quentinper/Orphea/020925_AA-Orphea_equipe/030925_AA_Orphéa/030925_--_Document_Conception/030925_40_--_PCB_Orphéa_Commande_Solénoide.pdf

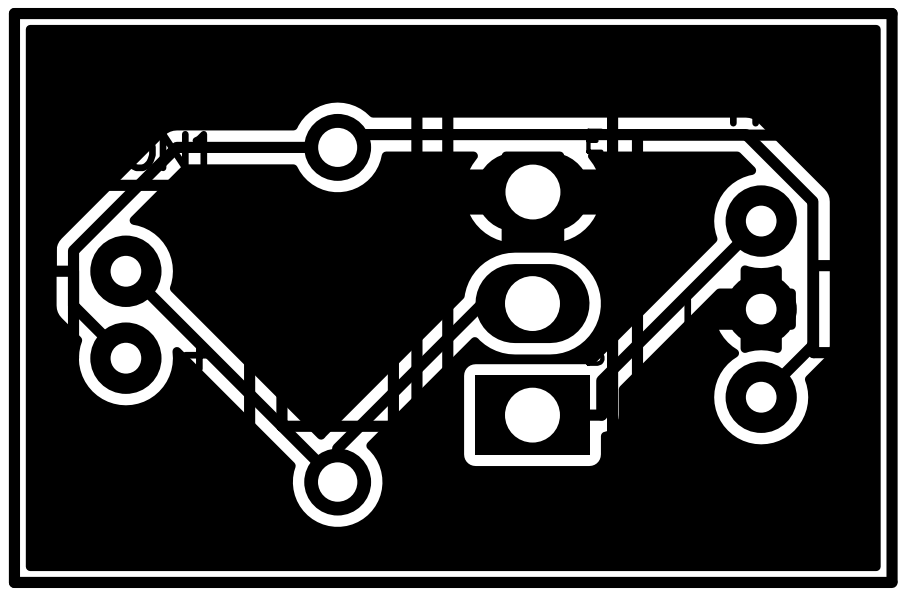
[picture p18: page 1]
