quentinper/Orphea/020925_AA-Orphea_equipe/030925_AA_Orphéa/030925_--_Document_Avant_Projet/030925_03_--_Analyse_fonctionnelle.pdf

BUT 3 – SAE S5

CY IUT – GEII Neuville

# Analyse fonctionnelle

### Projet Clavier Automatisé

Document rédigé par : William Le Coënt & Lorenzo Salvatore & Quentin Perbost
Ref : 05092025_3_–

BUT 3 – SAE S5 | Analyse Fonctionnelle
Projet Clavier Automatisé

ENREGISTREMENT DES MODIFICATIONS

Version | Date | Auteur | Modification
– | 05/09/2025 | W.LE-COËNT | Création / Réalisation
AA | 07/10/2025 | Q.PERBOST | Finition

### APPROBATION

| Nom | Rôle | Signature | Date
Écrit par | W.LE-COËNT | Technicien
Vérifié par | L.SALVATORE | Technicien
Approuvé par | Q.PERBOST | Technicien
Approuvé par le client si nécessaire | V.GAUTHIER | Client
Ref : 05092025_3_– | 2

### Contexte

Ce document à pour objectif de décrire les besoins du client liés au projet Orchestrion du clavier automatisé.

Ce document est applicable pour le projet “ Clavier Automatisé ”

### Table des matières

### 1 - Etude Pré Projet

1.1 - Diagramme Bête à corne

Il permet d’identifier le besoin fondamental, l’utilisateur et l’objectif principal du système.

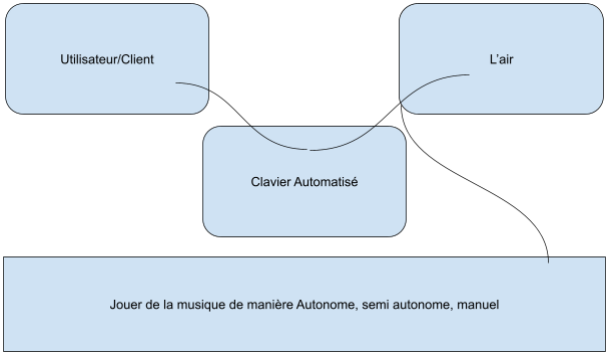
[picture p22: figure]

1.2 - Diagramme Pieuvre

Il met en évidence les interactions entre le système étudié et son environnement (acteurs ou contraintes externes).

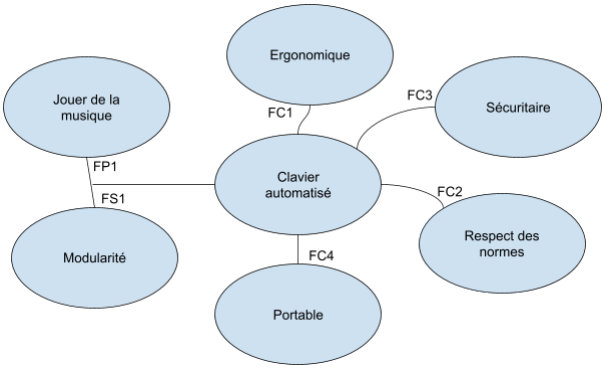
[picture p23: figure]

1.3 - Diagramme FAST

Il décompose les fonctions d’un système en les reliant sous forme logique pour comprendre comment elles répondent au besoin.

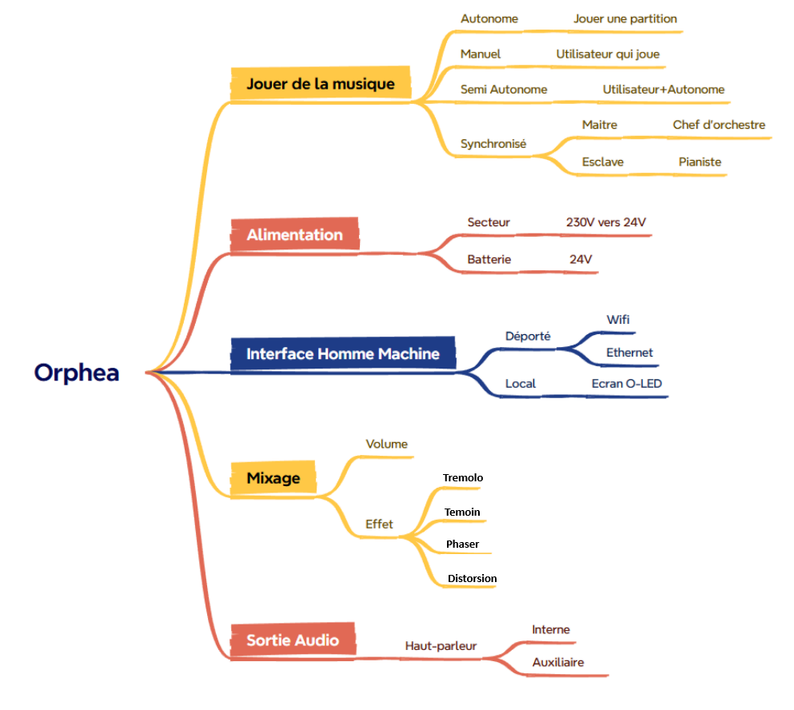
[picture p24: figure]

1.4 - Chaîne d'énergie et de communication

Elle décrit comment l’énergie et les informations circulent dans le système, depuis l’entrée jusqu’à la sortie.

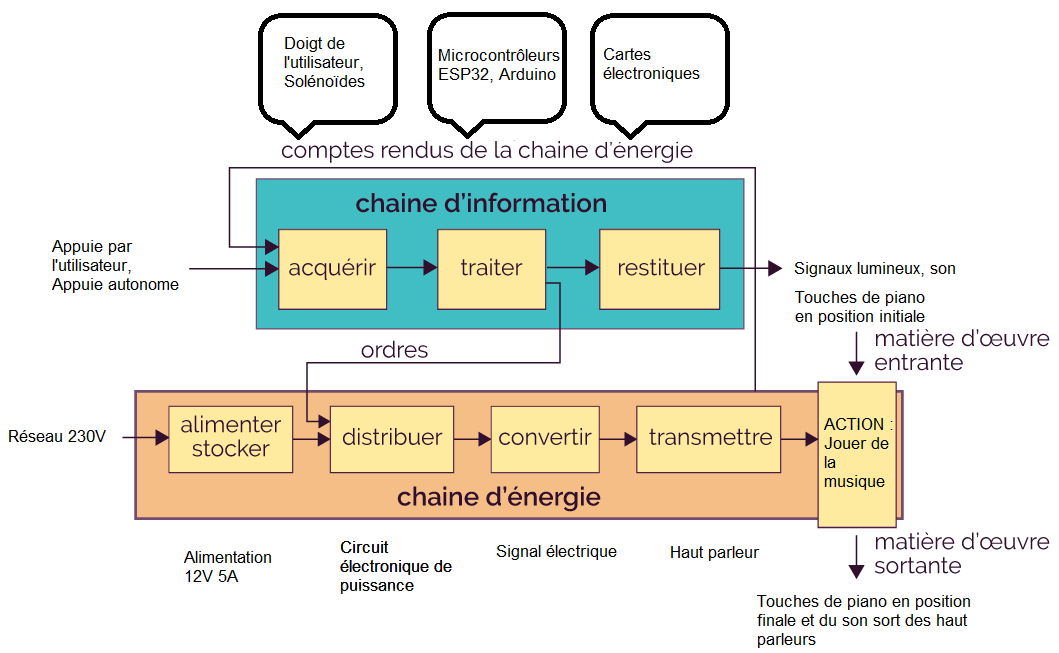
[picture p25: figure]
