quentinper/Orphea/020925_AA-Orphea_equipe/080925_AA_Programmation/080925_--_Environnement_de_Compilation/080925_140_--_Notice_de_Compilation.pdf

BUT 3 – SAE S5

CY IUT – GEII Neuville

# Notice de Compilation

## Projet Orphéa

### Document rédigé par : William Le Coënt & Lorenzo Salvatore & Quentin Perbost Réf : 08092025_140_– _Notice_de_Compilation

BUT 3 – SAE S5 | Notice de Compilation
Projet Clavier Automatisé

### ENREGISTREMENT DES MODIFICATIONS

Version | Date | Auteur | Modification
– | 05/01/2026 | Q.PERBOST | Création

## APPROBATION

| Nom | Rôle | Signature | Date
Écrit par | Q.PERBOST | Technicien
Vérifié par | L.SALVATORE | Technicien
Approuvé par | W.LE-COËNT | Technicien
Approuvé par le client si nécessaire | V.GAUTHIER | Client
Ref : 080925_140_– | 2

## Contexte

Ce document à pour objectif de décrire la mise en place de l’environnement de compilation et de programmation du projet.

Ce document est applicable pour le projet Orphéa

## Table des matières

## 1. Prérequis

- Votre Machine doit être équipé de Visual Studio Code.

### - Les pilotes de la carte ESP32 doivent être installés ils sont en lien ci dessous :

★ Lien-driver (https://randomnerdtutorials.com/install-esp32-esp8266-usb-drivers-cp210x-windows/)

## 2. Document de référence

### Ce munir de la dernière version à jour du software

– | SAE-S5V3 (https://drive.google.com/drive/folders/1pqauAC_4ReTE95huv6Qkbq_bhtFuraPZ?usp=drive_link)

## 3. Installation de PlatFormIO

Cette partie ne concerne que les personnes n’ayant pas déjà installer le plugin.

L’installation du plugin PlatForm se verra sous la forme d’une procédure,

Veuillez compléter celle- ci pour ne pas oublier d'étape.

Etape | Description | Résultat
1 | Ouvrir VS Code
2 | Cliquez sur l'icône suivante :

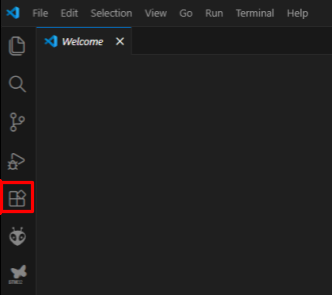
[picture p26: figure]
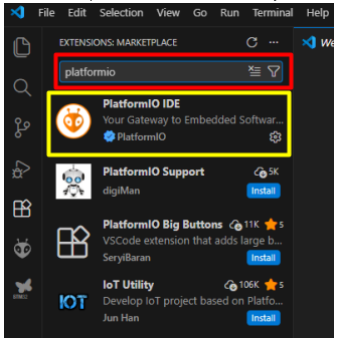
[picture p27: figure]

3 | Saisir “platformio” et cliquez sur l’extension entouré en jaune

4 | Cliquez sur Install et attendez la fin de l’installation

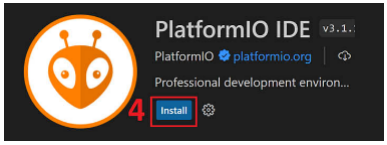
[picture p28: figure]

5 | Redémarrez VS Code, vous devriez avoir le logo PlatformIO : Cliquez dessus

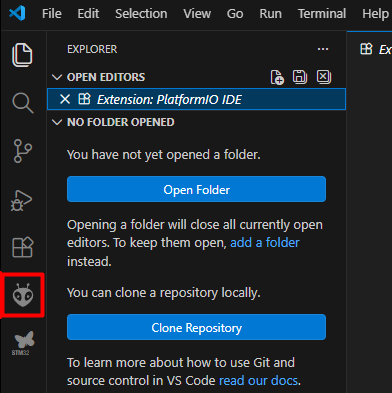
[picture p29: figure]

6 | Selectionnez : Pick a folder

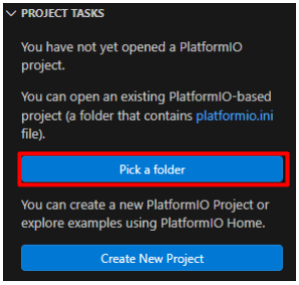
[picture p30: figure]
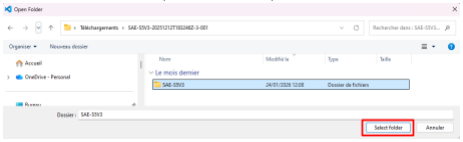
[picture p31: figure]

7 | Ouvrez le fichier SAE-S5V3 ( Dernier Software)

8 Pour compiler le projet, ou l’upload sur l'esp 32 :

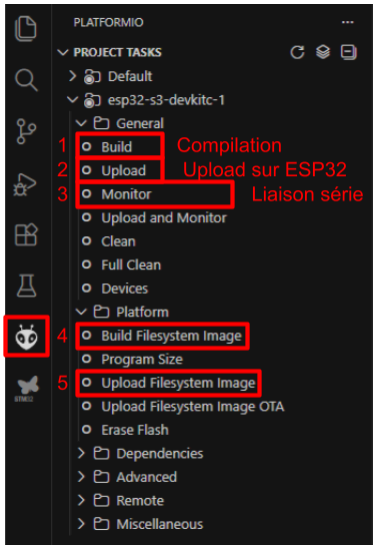
[picture p32: figure]

Pour une compilation après changement sur une partie C/C++ ayant eu lieu dans le répertoire : → lib ou → src
Etape à suivre 1→2→3

Si une modification concerne un programme dans le répertoire : → Data Etape à suivre 4→5→2→3

## Nota

Une erreur de port de communication peut avoir lieu lorsque plusieurs carte sont connectés au même PC, pour éviter cette erreur vous pouvez sélectionner le port voulus

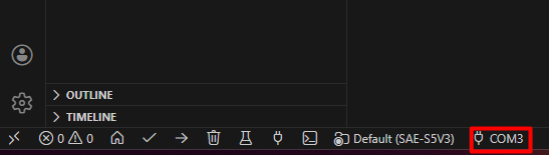
[picture p33: figure]

Cliquez ensuite sur le port de la carte à programmer.
