quentinper/Orphea/020925_AA-Orphea_equipe/030925_AA_Orphéa/030925_--_Document_Fabrication/030925_01_--_BOM_Orphéa.pdf

# LISTE DES ARTICLES NON CODIFIES

## NOT CODIFIED ITEMS LIST

QTE QTY | UNITE Unit | DESIGNATION NAME | CODE FABRICANT MANUFACTURER CODE | FABRICANT MANUFACTURER | EQUIVALENT ACCEPTE ACCEPTED ALTERNATIVE | REPERE TOPO TOPO ARK | OBSERVATION COMMENT
26 | | JST 2 Pin | B2B-PH-K-E(LF)(SN) CONN-TH_B2B-PH-K-S | | NON | IN 1/2/3/4/5 /6/7/8/9/10/11/12/ 13/14/15/16/17/18/ 19/20/21/22/23/24/25/26
26 | | JST 3 Pin | JST-3-PTH-VERT | | NON | SOL 1/2/3/4/5/6/7/8 9/10/11/12/13/14 15/16/17/18/19/20 21/22/23/24/25 SW1
3 | | Réseau de résistance 8*1 | RESEAU_DE_8_RESISTANCES | | OUI | RN1 RN2 RN3
1 | | Conencteur Dupon Male 1*4 | HDR-F-2.54_1x4 | | OUI | H5
1 | | Conencteur Dupon Male 1*16 | HDR-F-2.54_1X16 | | OUI | H6
1 | | Conencteur Dupon Male 1*6 | HDR-F-2.54_1X6 | | OUI | H7
1 | | Conencteur Dupon Male 1*8 | HDR-F-2.54_1X8 | | OUI | H8
4 | | Conencteur Dupon Male 1*10 | HDR-F-2.54_1X8 | | OUI | H1 H2 H3 H4
1 | | ESP 32 N16R8 | ESP32 S3 N16R8 | | NON | U1
1 | | ARDUINO Mega | Mega 2650 Pro mini 5V | | NON | U11
1 | | DAC I2S UDA1334A | UDA1334A Module Custom | | NON | U3
1 | | Régulateur L7812CV | L7812CV | | OUI | U8
1 | | Régulateur L7809CV | L7809CV | | OUI | U9
1 | | Régulateur L7805CV | L7805CV | | OUI | U10
1 | | Régulateur LM1086T 3,3V | LM1086T 3,3V | | OUI | U7
1 | | Barrel Jack DC 9-24V | 9-24V/50W 5.5X2.1 BARREL JACK | | OUI | U2
4 | | Condensateur 330 nF | C_RAD-0.2_US | | OUI | C4 C7 C9 C13
3 | | Condensateur 100 nF | C_RAD-0.2_US | | OUI | C5 C6 C8
2 | | Condensateur 10 µF | C_Tan_SMD_A_EU | | OUI | C10 C11
1 | | Condensateur 330 µF | C_Tan_SMD_A_EU | | OUI | C12
1 | | Condensateur 10 nF | C_RAD-0.2_US | | OUI | C14
1 | | Condensateur 1 µF | CE_TH_D5.0×F2.0_EU | | OUI | C15
1 | | Condensateur 47 nF | C_RAD-0.2_US | | OUI | C16
1 | | Condensateur 250 µF | CE_TH_D5.0×F2.0_EU | | OUI | C17
2 | | Diode 1N4148 | 1N4148 | | OUI | D1 D2
5 | | Résistance 1/4W de 10k Ohm | R_AXIAL-0.4_EU | | OUI | R2 R4 R5 R25 R26
1 | | Résistance 1/4W de 27k Ohm | R_AXIAL-0.4_EU | | OUI | R1
1 | | Résistance 1/4W de 18k Ohm | R_AXIAL-0.4_EU | | OUI | R3
1 | | Résistance 1/4W de 5,1k Ohm | R_AXIAL-0.4_EU | | OUI | R6
1 | | Fils | NA | | OUI | R7 R8
1 | | Résistance 3 W 1k Ohm | R_AXIAL-0.6_EU | | OUI | R10
1 | | Amplificateur Audio | LM386N-1_C2835213 | | NON | U12
DESSINE / DRAWN : | REV | DATE | MODIFICATION
| -- | 11/12/2025 | Creation
VISA : | 1/1 PLANCHE / SHEET : | | DESIGNATION / NAME :

VERIFIE / CHECKED :
030925_01_--_BOM_Orphéa | --

APPROUVE / APPROVED :
