quentinper/Orphea/020925_AA-Orphea_equipe/030925_AA_Orphéa/030925_--_Document_Fabrication/030925_01_--_BOM_Orphéa_Commande_Solénoide.pdf

# LISTE DES ARTICLES NON CODIFIES

## NOT CODIFIED ITEMS LIST

QTE | UNITE | DESIGNATION | CODE | FABRICANT | EQUIVALENT | REPERE | OBSERVATION
1 | | JST 2 Pin | B2B-PH-K-E(LF)(SN) CONN-TH_B2B-PH-K-S | | NON | CON1
1 | | JST 3 Pin | 2 pin connector | | NON | H1
1 | | Diode 1N4007 | 1N4007W | | OUI | D1
1 | | D44H11 | D44H11_C3200935 | | OUI | Q1
DESSINE / DRAWN : | REV | DATE | MODIFICATION
| -- | 11/12/2025 | Creation
VISA : | PLANCHE / SHEET : 1/1

VERIFIE / CHECKED :

APPROUVE / APPROVED :

030925_01_--_BOM_Orphéa_Commande_Solénoide | -- DESIGNATION / NAME :
