quentinper/Orphea/020925_AA-Orphea_equipe/040925_AA_Tremolo/040925_--_Document_Fabrication/040925_01_--_BOM_Tremolo.pdf

# LISTE DES ARTICLES NON CODIFIES

## NOT CODIFIED ITEMS LIST

QTE QTY | UNITE Unit | DESIGNATION NAME | CODE FABRICANT MANUFACTURER CODE | FABRICANT MANUFACTURER | EQUIVALENT ACCEPTE ACCEPTED ALTERNATIVE | REPERE TOPO TOPO ARK | OBSERVATION COMMENT
1 | | Condensateur 10 µF | CAP-D5.0-F2.0 | | | C1
1 | | Diode | 1N4148 | | | D1
1 | | Connecteur dupont Femelle 1 * 10 | HDR-F-2.54_1x10 | | | J1
1 | | Connecteur dupont Femelle 1 * 3 | HDR-F-2.54_1x3 | | | H3
1 | | Light diode resistor | LDR07 | | | LDR1
1 | | LED blanche 5 mm | LED 5mm | | | LED1
1 | | Transistor | 2n2646 | | | Q1
1 | | Resitance 1/4 W 0,4cm | 220 | | | R1
1 | | Resitance 1/4 W 0,4cm | 4K7 | | | R2
1 | | Resitance 1/4 W 0,4cm | 47 | | | R3
1 | | Resitance 1/4 W 0,4cm | 300 | | | R4
1 | | Resitance 1/4 W 0,4cm | 22K | | | RV1
1 | | Resitance 1/4 W 0,4cm | 4K7 | | | RV2
1 | | Amplificateur Opérationel | TL081 | | | U1
35 | mm | Gaine thermorétractable 5mm | N/A | | Y | N/A | Gaine à poser autour de LED1 jusqu'à LDR1
DESSINE / DRAWN : | REV | DATE | MODIFICATION
| -- | 11/12/2025 | Creation
VISA : | PLANCHE / SHEET : 1/1 | | DESIGNATION / NAME :

VERIFIE / CHECKED :
040925-_01_--_BOM_Tremolo | --

APPROUVE / APPROVED :
