quentinper/Orphea/020925_AA-Orphea_equipe/060925_AA_Phaser/060925_--_Document_Fabrication/060925_01_--_BOM_Phaser.pdf

## LISTE DES ARTICLES NON CODIFIES

### NOT CODIFIED ITEMS LIST

QTE | UNITE | DESIGNATION | CODE | FABRICANT | EQUIVALENT | REPERE | OBSERVATION
2 | | Condensateur 10nF | CAP-TH_L7.5-W4.0-P5.00-D0.5 | | OUI | C1,C8
4 | | Condensateur 47nF | CAP-TH_L7.5-W4.0-P5.00-D0.5 | | OUI | C2,C3,C4,C7
2 | | Condensateur 100nF | CAP-TH_L7.5-W4.0-P5.00-D0.5 | | OUI | C5,C6
1 | | Condensateur Chimique 47uF | CAP-D3.0×F1.5 | | OUI | C9
1 | | Condensateur Chimique 10u | CAP-D3.0×F1.5 | | OUI | C10
1 | | Diode 1N4148 | DO-35_BD2.0-L4.2-P8.20-D0.5-RD | | OUI | D1
1 | | ZENER_DIODE DEON | DC-ZENER-DIODE | | OUI | D2
1 | | HDR-F-2.54_1x10 | EFFET_AUDIO | | NON | H1
3 | | HDR-F-2.54_1x3 | JST-3-PTH-VERT | | NON | H2,H3,H4
2 | | J113FS-ND | TO-92-3 | | OUI | Q1,Q2
1 | | Transistor BC559 | BC559 | | OUI | Q3
2 | | Résitance 1/4W 2.2M | R_AXIAL-0.4 | | OUI | R1,R3
10 | | Résitance 1/4W 10k | R_AXIAL-0.4 | | OUI | R2,R4,R5,R6,R7,R8,R9,R16,R20,R21
6 | | Résitance 1/4W 150k | R_AXIAL-0.4 | | OUI | R10,R11,R12,R14,R17,R19
1 | | Résitance 1/4W 47k | R_AXIAL-0.4 | | OUI | R13
1 | | Résitance 1/4W 3M | R_AXIAL-0.4 | | OUI | R15
1 | | Résitance 1/4W 470k | R_AXIAL-0.4 | | OUI | R18
2 | | AOP TL072MJGB | DIP8 | | OUI | U1A,U2B
2 | | AOP TL072MJGB | DIP8 | | OUI | U1B,U2A
DESSINE / DRAWN : | REV | DATE | MODIFICATION
| -- | 11/12/2025 | Creation
VISA : | 1/1 PLANCHE / SHEET : | | DESIGNATION / NAME :

VERIFIE / CHECKED :
030925-_01_--_BOM_Phaser | --

APPROUVE / APPROVED :
