quentinper/Orphea/020925_AA-Orphea_equipe/030925_AA_Orphéa/030925_--_Document_Conception/030925_60_--_Touche_D.STL

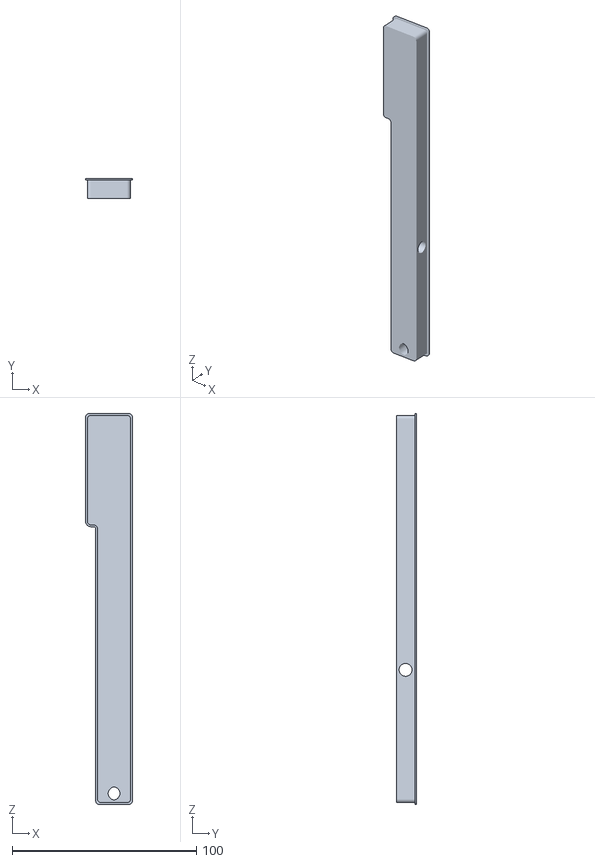
[picture p34: CAD file, 2026-02-11]
020925_AA-Orphea_equipe/030925_AA_Orphéa/030925_--_Document_Conception/030925_60_--_Touche_D.STL
25.5 x 11.0 x 212.0
