quentinper/Orphea/020925_AA-Orphea_equipe/030925_AA_Orphéa/030925_--_Document_Conception/030925_60_--_Touche_noir.STL

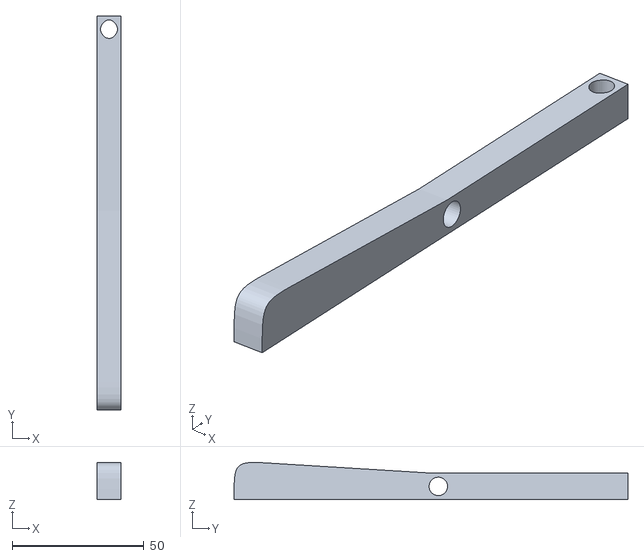
[picture p35: CAD file, 2026-02-11]
020925_AA-Orphea_equipe/030925_AA_Orphéa/030925_--_Document_Conception/030925_60_--_Touche_noir.STL
9.00 x 149.6 x 14.1
