quentinper/Orphea/020925_AA-Orphea_equipe/030925_AA_Orphéa/030925_--_Document_Conception/030925_60_--_Touche_T.STL

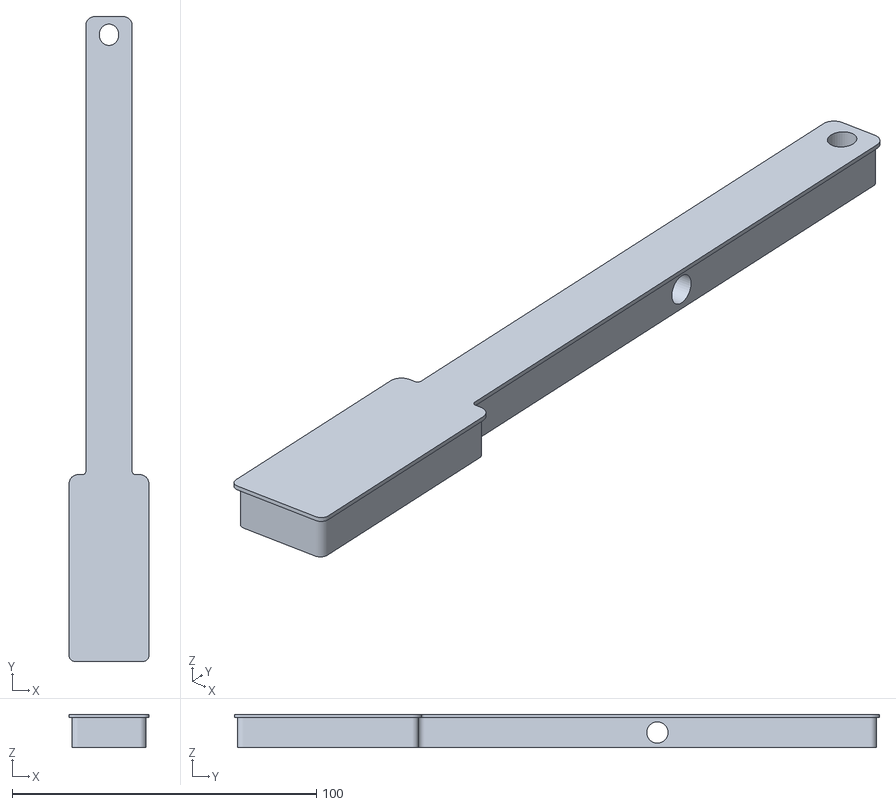
[picture p36: CAD file, 2026-02-11]
020925_AA-Orphea_equipe/030925_AA_Orphéa/030925_--_Document_Conception/030925_60_--_Touche_T.STL
26.3 x 212.0 x 11.0
