quentinper/Orphea/020925_AA-Orphea_equipe/030925_AA_Orphéa/030925_--_Document_Conception/030925_60_--_Socle_Disposition.STL

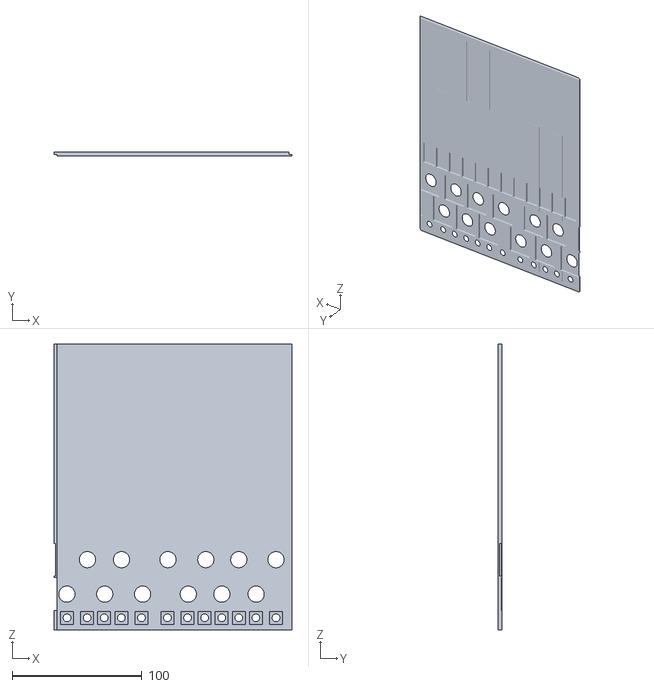
[picture p37: CAD file, 2026-02-11]
020925_AA-Orphea_equipe/030925_AA_Orphéa/030925_--_Document_Conception/030925_60_--_Socle_Disposition.STL
183.0 x 3.00 x 220.0
