quentinper/Orphea/020925_AA-Orphea_equipe/030925_AA_Orphéa/030925_--_Document_Conception/030925_50_--_Touche_noir.SLDPRT

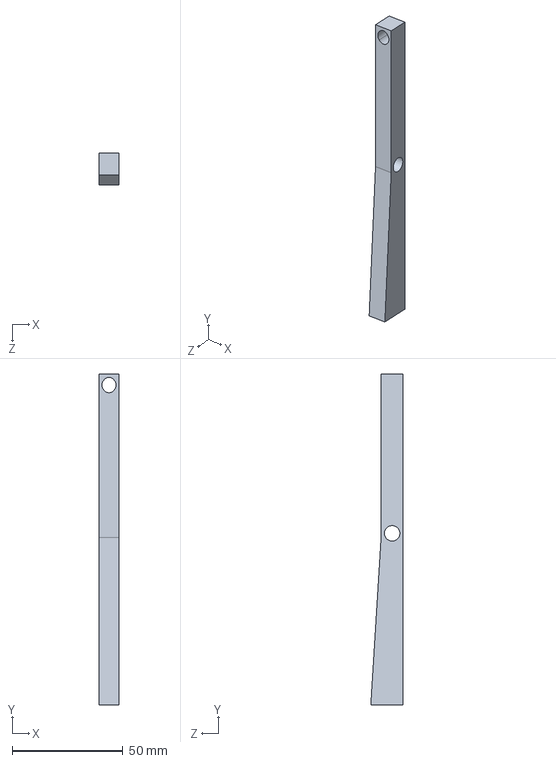
[picture p38: CAD file, 2026-02-11]
020925_AA-Orphea_equipe/030925_AA_Orphéa/030925_--_Document_Conception/030925_50_--_Touche_noir.SLDPRT
9.00 x 149.6 x 14.7 mm
