quentinper/Orphea/(list of files, cad)

Other CAD files:
020925_AA-Orphea_equipe/030925_AA_Orphéa/030925_--_Document_Conception/030925_50_--_Socle_Disposition.SLDPRT
020925_AA-Orphea_equipe/030925_AA_Orphéa/030925_--_Document_Conception/030925_60_--_Touche_B.SLDPRT
020925_AA-Orphea_equipe/030925_AA_Orphéa/030925_--_Document_Conception/030925_50_--_Touche_T.SLDPRT
020925_AA-Orphea_equipe/030925_AA_Orphéa/030925_--_Document_Conception/030925_50_--_Touche_D.SLDPRT
020925_AA-Orphea_equipe/030925_AA_Orphéa/030925_--_Document_Conception/030925_60_--_Touche_B.STL
