quentinper/Orphea/020925_AA-Orphea_equipe/030925_AA_Orphéa/030925_--_Document_Fabrication/030925_120_--_Notice_de_Fabrication.pdf

BUT 3 – SAE S5

CY IUT – GEII Neuville

# Notice de Fabrication

### Projet Orphéa

Document rédigé par : William Le Coënt & Lorenzo Salvatore & Quentin Perbost
Ref : 030925_120_–

BUT 3 – SAE S5 | Notice de Fabrication
Projet Orphéa

ENREGISTREMENT DES MODIFICATIONS

Version | Date | Auteur | Modification
– | 05/02/2026 | Q.PERBOST | Création / Réalisation

### APPROBATION

| Nom | Rôle | Signature | Date
Écrit par | W.LE-COËNT | Technicien
Vérifié par | L.SALVATORE | Technicien
Approuvé par | Q.PERBOST | Technicien
Approuvé par le client si nécessaire | V.GAUTHIER | Client
Ref : 030925_120_– | 2

### Contexte

Ce Document a pour objectif d’expliquer ou trouver les documents nécessaire à la fabrication du produit 030925_AA_–

Ce document est applicable pour le projet Orphéa

### Table des matières

### 1. PCB à fabriquer

Les fichiers gerber ci-dessous doivent être fabriqués avant de poursuivre cette notice de fabrication pour un montage plus optimisé et plus rapide.

Version | Référence
– | 030925_AA-Orphéa.zip (https://drive.google.com/open?id=1MJaIf8cCI9vSBsuECvsK-OiB_F2n1HKR&usp=drive_copy)
– | 030925_AA-Orphéa_Input.zip (https://drive.google.com/open?id=1KFRMCZIGSjf2PSJPVdTlJNBTOrNPTREW&usp=drive_copy)
– | 030925_AA-Orphéa_Commande_Solénoide.zip (https://drive.google.com/open?id=1vPtllNnsLdU4Q-la1BXOT_rWYhflYjbl&usp=drive_copy)

### 2. Document de référence

Voici la liste des documents dont vous devez vous munir pour la fabrication du projet

Rev. | ID | Référence
– | [DOC_1] | 030925_01_--_BOM_Orphéa.xlsx (https://drive.google.com/open?id=1cFcTzTJ-_1iIptJQ9sIWQ17MXSiVi3A0&usp=drive_copy)
– | [DOC_2] | 030925_01_--_BOM_Orphéa_Commande_Solénoide.xlsx (https://drive.google.com/open?id=1UctstFq2_wEVplDSK5WlD0LE7irIBF55&usp=drive_copy)
– | [DOC_3] | 030925_01_--_BOM_Orphéa_Input.xlsx (https://drive.google.com/open?id=1zueOFICsPvC69y0jSzsYh7GkB0jgByN6&usp=drive_copy)
– | [DOC_4] | 030925_30_--_SCH_Orphéa.pdf (https://drive.google.com/open?id=1c9c5VVA-9PQ9eq73eIMtzalOfJyQ0_z-&usp=drive_copy)
– | [DOC_5] | 030925_30_--_SCH_Orphéa_Input.pdf (https://drive.google.com/open?id=1u-wsKWYbWfl0K4HPJp2ZCQ8DPJnlRkFw&usp=drive_copy)
– | [DOC_6] | 030925_30_--_SCH_Orphéa_Commande_Solénoide.pdf (https://drive.google.com/open?id=1sCVTzVvemFqlkLfWxzCjUXkuewX26R21&usp=drive_copy)
– | [DOC_7] | 030925_40_--_PCB_Orphéa.pdf (https://drive.google.com/open?id=1fQ0kqTGfpIrXZEkwX_TVGB-6tLynysM0&usp=drive_copy)
– | [DOC_8] | 030925_40_--_PCB_Orphéa_Input.pdf (https://drive.google.com/open?id=1be8S5Mmi7bKta0vz6i5-T-B6fvt76pcW&usp=drive_copy)
– | [DOC_9] | 030925_40_--_PCB_Orphéa_Commande_Solénoide.pdf (https://drive.google.com/open?id=1hRNOdILzSAt9gT65Mzug-pyimkrSE0Hs&usp=drive_copy)

### 3. Fabrication de la carte Orphéa

Matériel nécessaire :

- Fer à braser
- Etain

Pour la fabrication de la carte Orphéa

Munissez vous des documents suivants :

La BOM : [DOC_1]

Le Schéma électrique : [DOC_4]

La vue PCB : [DOC_7]

Ensuite, à l’aide de la BOM de la vue PCB, placer les composants appropriés conformément aux indications de la BOM.

### 4. Fabrication de la carte Orphéa Input

Matériel nécessaire :

- Fer à braser
- Etain

Pour la fabrication de la carte Orphéa Input

Munissez vous des documents suivants :

La BOM : [DOC_3]

Le Schéma électrique : [DOC_5]

La vue PCB : [DOC_8]

Ensuite, à l’aide de la BOM de la vue PCB, placer les composants appropriés conformément aux indications de la BOM.

### 5. Fabrication de la carte Orphéa Commande Solénoïde

Matériel nécessaire :

- Fer à braser
- Etain

Pour la fabrication de la carte Orphéa Commande Solénoïde

Munissez vous des documents suivants :

La BOM : [DOC_2]

Le Schéma électrique : [DOC_6]

La vue PCB : [DOC_9]

Ensuite, à l’aide de la BOM de la vue PCB, placer les composants appropriés conformément aux indications de la BOM.

### 6. Fin de Fabrication

A la fin de la fabrication, la complétude de la procédure de vérification est le seul moyen d’attester le fonctionnement du produit fini.

Sans procédure de vérification validée le produit ne sera pas qualifié, et donc inutilisable.
