quentinper/Orphea/020925_AA-Orphea_equipe/040925_AA_Tremolo/040925_--_Document_Fabrication/040925_120_--_Notice_de_Fabrication.pdf

BUT 3 – SAE S5

CY IUT – GEII Neuville

# Notice de Fabrication

### Projet Orphéa

Document rédigé par : William Le Coënt & Lorenzo Salvatore & Quentin Perbost
Ref : 040925_120_–

BUT 3 – SAE S5 | Notice de Fabrication
Projet Orphéa

ENREGISTREMENT DES MODIFICATIONS

Version | Date | Auteur | Modification
– | 05/02/2026 | Q.PERBOST | Création / Réalisation

### APPROBATION

| Nom | Rôle | Signature | Date
Écrit par | W.LE-COËNT | Technicien
Vérifié par | L.SALVATORE | Technicien
Approuvé par | Q.PERBOST | Technicien
Approuvé par le client si nécessaire | V.GAUTHIER | Client
Ref : 040925_120_– | 2

### Contexte

Ce Document a pour objectif d’expliquer ou trouver les documents nécessaire à la fabrication du produit 040925_AA_–

Ce document est applicable pour le projet Orphéa

### Table des matières

### 1. PCB à fabriquer

Les fichiers gerber ci-dessous doivent être fabriqués avant de poursuivre cette notice de fabrication pour un montage plus optimisé et plus rapide.

Version | Référence
– | 040925_AA-Tremolo.zip (https://drive.google.com/open?id=1fis1Bre52-Uww-j_mt1sNsEiHA5dV_zZ&usp=drive_copy)

### 2. Document de référence

Voici la liste des documents dont vous devez vous munir pour la fabrication du projet

Rev. | ID | Référence
– | [DOC_1] | 040925_01_--_BOM_Tremolo.xlsx (https://drive.google.com/open?id=1g26WvUHa0v1416QwupnaKhoj-tPo-JM3&usp=drive_copy)
– | [DOC_2] | 040925_40_--_PCB_Tremolo.pdf (https://drive.google.com/open?id=1QOGghLmwrWbzp6UO_rvfRqJBoQ-E19s7&usp=drive_copy)
– | [DOC_3] | 040925_30_--_SCH_Tremolo.pdf (https://drive.google.com/open?id=1KRyi-VRHlaIbk53S2-lbXLk3gksu7JHb&usp=drive_copy)

### 3. Fabrication de la carte Tremolo

Matériel nécessaire :

- Fer à braser
- Etain

Pour la fabrication de la carte Tremolo

Munissez vous des documents suivants :

La BOM : [DOC_1]

Le Schéma électrique : [DOC_3]

La vue PCB : [DOC_2]

Ensuite, à l’aide de la BOM de la vue PCB, placer les composants appropriés conformément aux indications de la BOM.

### 4. Fin de Fabrication

A la fin de la fabrication, la complétude de la procédure de vérification est le seul moyen d’attester le fonctionnement du produit fini.

Sans procédure de vérification validée le produit ne sera pas qualifié, et donc inutilisable.
