quentinper/Orphea/020925_AA-Orphea_equipe/060925_AA_Phaser/060925_--_Document_Fabrication/060925_120_--_Notice_de_Fabrication.pdf

BUT 3 – SAE S5

CY IUT – GEII Neuville

# Notice de Fabrication

### Projet Orphéa

Document rédigé par : William Le Coënt & Lorenzo Salvatore & Quentin Perbost
Ref : 060925_120_–

BUT 3 – SAE S5 | Notice de Fabrication
Projet Orphéa

ENREGISTREMENT DES MODIFICATIONS

Version | Date | Auteur | Modification
– | 05/02/2026 | Q.PERBOST | Création / Réalisation

### APPROBATION

| Nom | Rôle | Signature | Date
Écrit par | W.LE-COËNT | Technicien
Vérifié par | L.SALVATORE | Technicien
Approuvé par | Q.PERBOST | Technicien
Approuvé par le client si nécessaire | V.GAUTHIER | Client
Ref : 060925_120_– | 2

### Contexte

Ce Document a pour objectif d’expliquer ou trouver les documents nécessaire à la fabrication du produit 060925_AA_–

Ce document est applicable pour le projet Orphéa

### Table des matières

### 1. PCB à fabriquer

Les fichiers gerber ci-dessous doivent être fabriqués avant de poursuivre cette notice de fabrication pour un montage plus optimisé et plus rapide.

Version | Référence
– | 060925_AA-Phaser.zip (https://drive.google.com/open?id=1HnntcHySsSspAS80iaairRMRRnt0LpVE&usp=drive_copy)

### 2. Document de référence

Voici la liste des documents dont vous devez vous munir pour la fabrication du projet

Rev. | ID | Référence
– | [DOC_1] | 060925_01_--_BOM_Phaser.xlsx (https://drive.google.com/open?id=1BJlcQZXmpmC8Kf-3Po1fSuvKMcR18Kl9&usp=drive_copy)
– | [DOC_2] | 060925_40_--_PCB_Effet_Phaser.pdf (https://drive.google.com/open?id=1yZ__yyKAkJjOExSmYNFNPs0QT_1oqM5M&usp=drive_copy)
– | [DOC_3] | 060925_30_--_SCH_Effet_Phaser.pdf (https://drive.google.com/open?id=1HajR4Ru-SJbkBCgCQOXqlLZenWzVVZAU&usp=drive_copy)

### 3. Fabrication de la carte Phaser

Matériel nécessaire :

- Fer à braser
- Etain

Pour la fabrication de la carte Phaser

Munissez vous des documents suivants :

La BOM : [DOC_1]

Le Schéma électrique : [DOC_3]

La vue PCB : [DOC_2]

Ensuite, à l’aide de la BOM de la vue PCB, placer les composants appropriés conformément aux indications de la BOM.

### 4. Fin de Fabrication

A la fin de la fabrication, la complétude de la procédure de vérification est le seul moyen d’attester le fonctionnement du produit fini.

Sans procédure de vérification validée le produit ne sera pas qualifié, et donc inutilisable.
