quentinper/Orphea/020925_AA-Orphea_equipe/030925_AA_Orphéa/030925_--_Document_Maintenance/030925_25_--_Procédure_de_maintenance_Orphéa.pdf

BUT 3 – SAE S5

CY IUT – GEII Neuville

# Procédure de maintenance

## Carte mère

### Document rédigé par : William Le Coënt & Lorenzo Salvatore & Quentin Perbost Ref : 030925_25_–_Procédure_de_maintenance_Orphéa

BUT 3 – SAE S5 | Procédure de maintenance (carte d’effet trémolo)
Projet Orphéa

## ENREGISTREMENT DES MODIFICATIONS

Version | Date | Auteur | Modification
– | 02/02/2026 | W. LE-COËNT | Création

## APPROBATION

| Nom | Rôle | Signature | Date
Écrit par | W. LE-COËNT | Technicien
Vérifié par | Q. PERBOST | Technicien
Approuvé par | L. SALVATORE | Technicien
Approuvé par le client si nécessaire | V. GAUTHIER | Client
030925_25_– | 2

## Avant-propos

Ce document porte sur la maintenance de la carte mère du projet Orphéa.
Il contient le planning et les procédure de maintenance préventive ainsi que les procédures de diagnostic et de maintenances corrective

La BOM applicable à cette procédure est le document référence 030925_01_--_BOM_Orphea.

## Documents de référence

Ci-dessous la liste des documents applicables à cette procédure.

Rev. | ID | Référence document
– | BOM | 030925_01_--_BOM_Orphea
– | PDV | 030925_80_--_Procedure_de_verification
– | N/A | 030925_30_--_SCH_Orphea
– | N/A | 030925_40_--_PCB_Orphea

## Table des matières

## 1. Pré-requis

Les interventions détaillées dans le présent document doivent être réalisées dans un environnement apte à la pratique de l’électronique. (zone protégée contre les ESD, bracelet et chaussures antistatiques)

### Matériel requis

Dénomination | Quantité
Multimètre | 1
Pointe de touche | 2
Poste de brasure | 1
Étain 60Sn/40Pb | 1
Tresse à dessouder cuivre | 1
Alcool isopropylique | 1
Câble fiche banane | 2
Oscilloscope | 1
Sonde d'oscilloscope | 1

## 2. Maintenance préventive

Opération | Périodicité
Remplacement du condensateur C10, C11, C12, C14, C15, C17 | 10 ans
Inspection des connecteurs JST des solénoïdes SOLX et des notes INX | Toutes les 50 utilisations ou tous les 2 ans.
Inspection des régulateurs de tension L7809, L7812, LM1086 | Tous les 3 ans
Inspection du régulateur de tension L7805 | Tous les ans
Mesure des signaux entrant de l’amplification audio | Tous les 10 ans
Se connecter à l’interface de maintenance | Lorsque panne de solénoïdes
Se connecter à l’interface de contrôle du piano à distance | Tous les 6 mois

### Remplacement des condensateurs

Afin de prévenir le risque de corrosion ou de court-circuit lié à la fuite de l’électrolyte des condensateurs chimiques de la carte mère, il est nécessaire de les remplacer de manière préventive.

Ils doivent impérativement être remplacés par un condensateur de caractéristiques identiques en se reportant à la BOM de la carte mère.

### Inspection des connecteurs JST des solénoïdes SOLX et des notes INX

Afin de prévenir le risque de défaillances ou de court-circuit lié à la dégradation des connecteurs de la carte, il est nécessaire de les inspecter de manière périodique afin d’évaluer leur état en réalisant des tests de continuité. Remplacer les connecteurs s’il sont endommagés.

Il doivent impérativement être remplacés par un connecteur identique en se reportant à la BOM de la carte mère.

### Inspection des régulateurs de tension L7805, L7809, L7812, LM1086

Afin de prévenir la panne des régulateurs de tensions et donc la panne du circuit, il est impératif que les régulateurs de tensions aient les caractéristiques en se reportant à la PDV de la carte mère.

### Mesure des signaux de l’amplification audio

Afin de prévenir la panne de l’amplificateur de puissance LM386 et donc la panne de la fonction de son, il est impératif que les mesures des signaux générés par le DAC I2S s’approchent ou corresponde au taux de distorsion harmonique en se reportant à la PDV de la carte mère.

### Se connecter à l’interface de maintenance

Afin de prévenir la panne des transistors reliés aux solénoïdes, il sera important de se connecter à l’IHM de contrôle à distance de maintenance en se connectant au réseau WiFi de l’ESP-32 :

1. Connexion au réseau Wifi Orphea :
a. Mdp: Orphea_BUT3
2. Lien internet : http://192.168.4.1/maintenance

Il faudra tester toutes les fonctions, Solénoïdes et Carte à effet.

### Se connecter à l’interface de contrôle du piano à distance

Afin de prévenir la panne du logiciel implémenté dans l’ESP-32, il faudra tester chacune des touches en mode semi-automatique et ajouter, en mode automatique, un fichier MIDI. Ces deux étapes doivent être réalisées en se connectant au réseau WiFi de l’ESP-32 :

1. Connexion au réseau Wifi Orphea :
a. Mdp: Orphea_BUT3
2. Lien internet : http://192.168.4.1/piano

## 3. Diagnostiques

Avant de diagnostiquer la carte, assurez-vous que le fusible est bien présent et qu’il n’a pas fondu. Si toutefois la carte mère ne fonctionne pas avec la carte reliée à une alimentation de 24V, suivez cette
procédure | de | diagnostic.

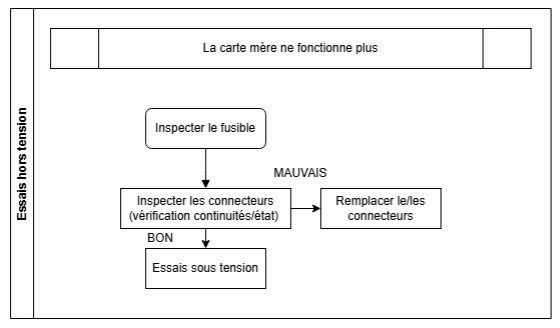
[picture p39: figure]

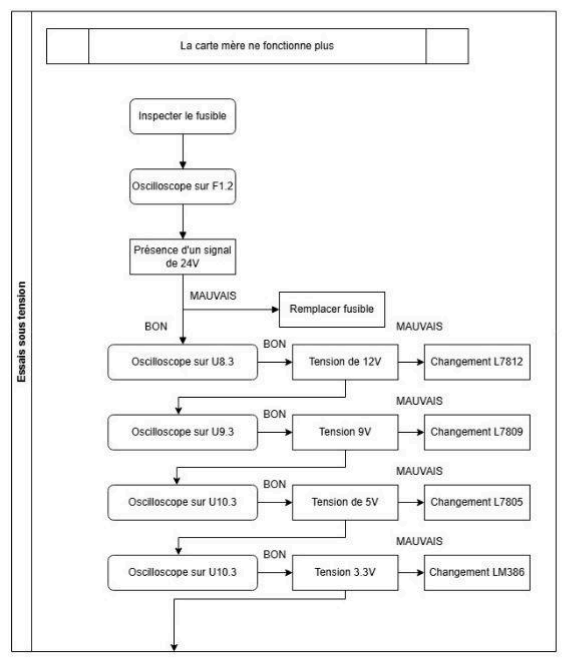
[picture p40: figure]

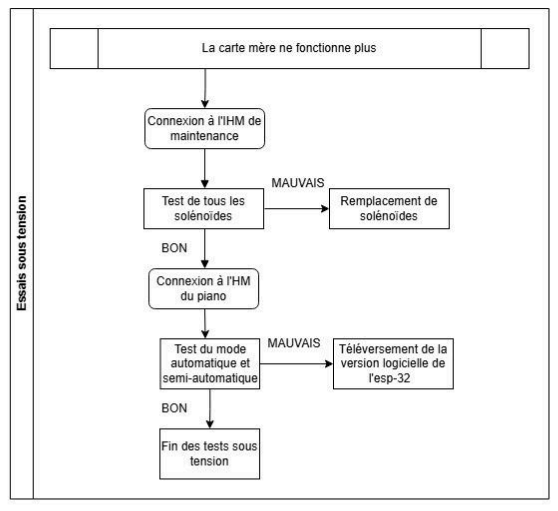
[picture p41: figure]

## 4. Maintenance corrective

### Remplacement des connecteurs JST des solénoïdes SOLX et des notes INX

En cas de défaillance de l’un des connecteurs JST, le remplacer par une référence identique ou équivalente en se reportant à la BOM de la carte d’effet trémolo. Couper les broches du connecteur, débraser les parties restantes et retirer l’étain afin de dégager les trous. Ensuite, mettre en place et braser le connecteur neuf, puis nettoyer à l’alcool isopropylique. Vérifier le sens.

### Remplacement du fusible

En cas de fonte du fusible, le remplacer par une référence identique ou équivalente en se reportant à la BOM de la carte mère. Ouvrir le boitier, retirer le fusible et ajouter le nouveau fusible.

### Remplacement des régulateurs de tension

En cas de défaillance des régulateurs de tension, le/les remplacer par une référence identique en se reportant à la BOM de la carte mère. Débraser le/les régulateurs et retirer l’étain afin de dégager les trous. Ensuite, mettre en place et braser le/les nouveau.x régulateur.s en respectant le brochage, puis nettoyer à l’alcool isopropylique.

### Remplacement du logiciel sur l’ESP-32

En cas de défaillance des IHM de maintenance et de piano pour les modes semi-automatique et automatique, récupérer les dossiers de programmation et téléverser le programme à l’aide de Visual Studio Code et Platform.io. Compiler et téléverser le logiciel dans la carte ESP-32. S’assurer le fonctionnement de cette dernière.
