quentinper/Orphea/020925_AA-Orphea_equipe/080925_AA_Programmation/080925_--_Document_Conception/080925_150_--_Diagramme_de_classe_Arduino_Mega.pdf

## Diagramme de classe Arduino MEGA

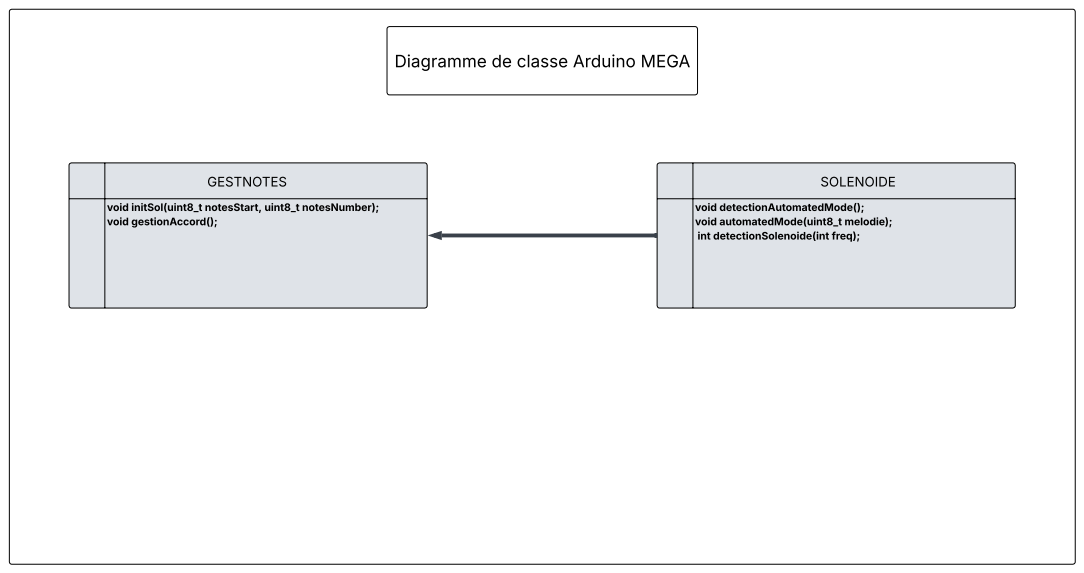
[picture p44: page 1]
GESTNOTES; SOLENOIDE

void initSol(uint8_t notesStart, uint8_t notesNumber);
void gestionAccord();

void detectionAutomatedMode();
void automatedMode(uint8_t melodie);
int detectionSolenoide(int freq);
