quentinper/Orphea/020925_AA-Orphea_equipe/030925_AA_Orphéa/030925_--_Document_Conception/030925_30_--_SCH_Orphéa_Input.pdf

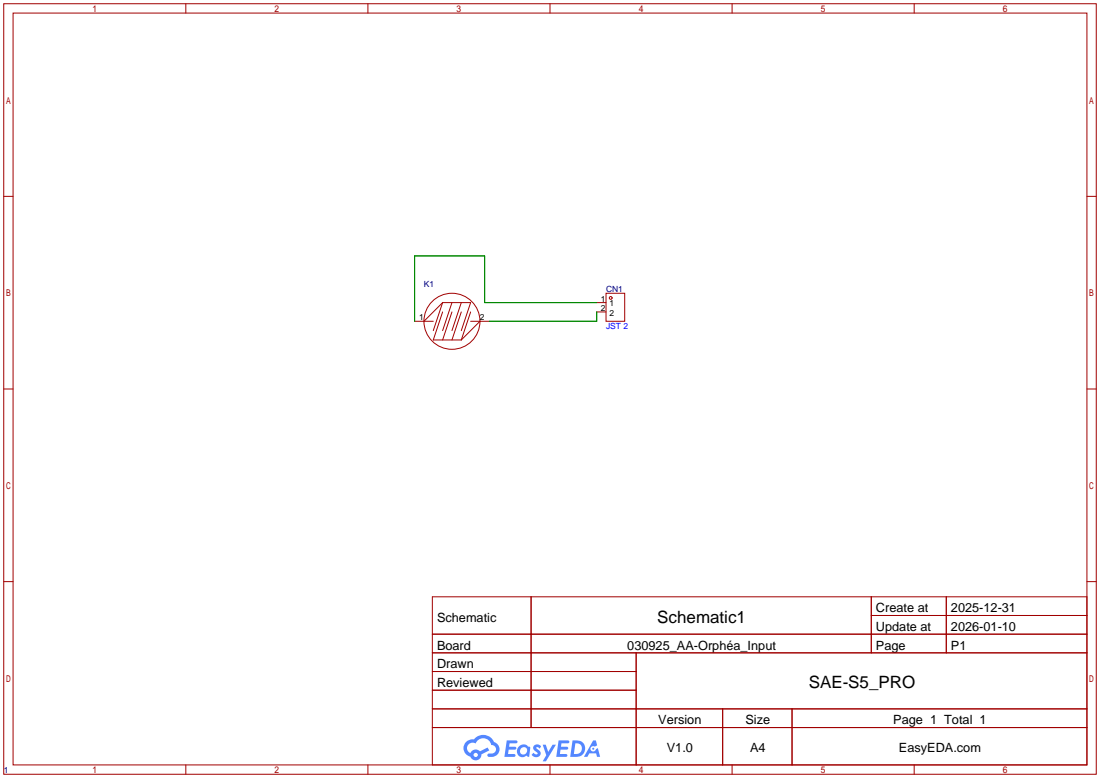
[picture p45: page 1]

Schematic | Schematic1 | Create at | 2025-12-31

Update at | 2026-01-10

Board | 030925_AA-Orphéa_Input | Page | P1
Drawn | | SAE-S5_PRO
Reviewed

Version | Size | Page 1 Total 1
V1.0 | A4 | EasyEDA.com
