quentinper/Orphea/020925_AA-Orphea_equipe/030925_AA_Orphéa/030925_--_Document_Conception/030925_70_--_Socle_Disposition.pdf

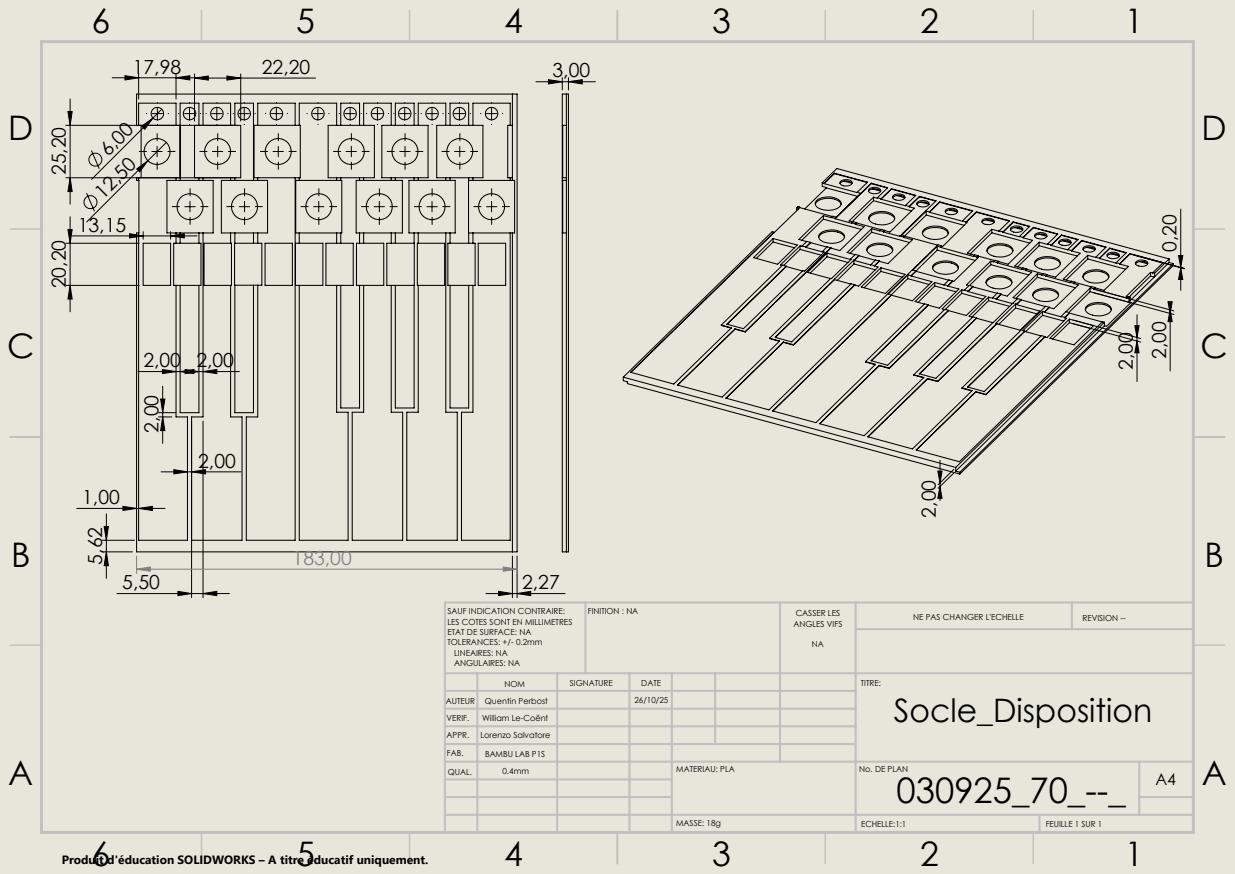
[picture p46: page 1]
FINITION : NA; CASSER LES; ANGLES VIFS; NE PAS CHANGER L'ECHELLE; REVISION --; ECHELLE:1:1; FEUILLE 1 SUR 1; MASSE: 18g

SAUF INDICATION CONTRAIRE:
LES COTES SONT EN MILLIMETRES
ETAT DE SURFACE: NA
TOLERANCES: +/- 0.2mm
LINEAIRES: NA
ANGULAIRES: NA

NOM | SIGNATURE | DATE | | | | TITRE: Socle_Disposition

AUTEUR | Quentin Perbost | | 26/10/25

VERIF. | William Le-Coënt
APPR. | Lorenzo Salvatore
FAB. | BAMBU LAB P1S
QUAL. | 0.4mm | | | MATERIAU: PLA | No. DE PLAN 030925_70_--_ | A4

Produit d'éducation SOLIDWORKS – A titre éducatif uniquement.
