quentinper/Orphea/020925_AA-Orphea_equipe/080925_AA_Programmation/080925_--_Document_Conception/080925_130_--_Algorigramme_ESP32.pdf

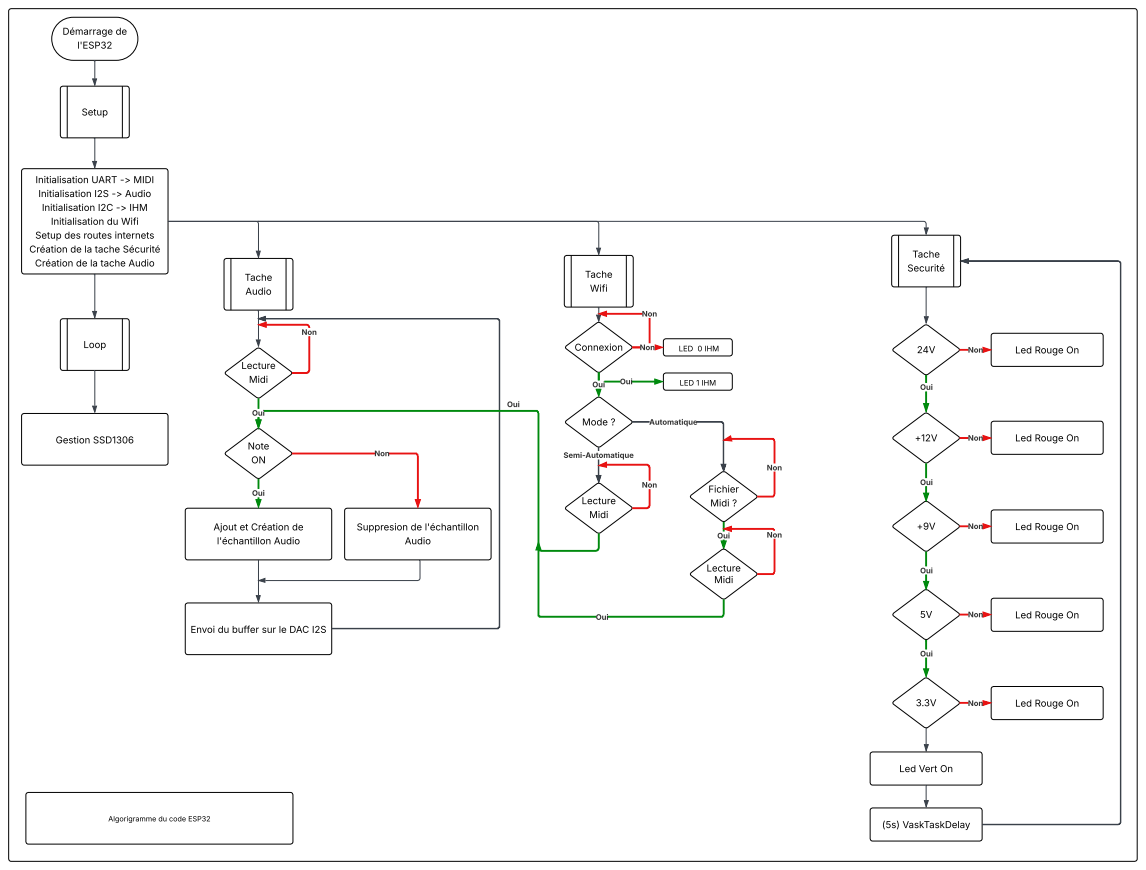
[picture p47: page 1]
Démarrage de l'ESP32; Setup; Loop; Gestion SSD1306; Tache Audio; Lecture Midi; Non; Note ON; Oui; Audio; Tache Securité; Led Rouge On; (5s) VaskTaskDelay; Tache Wifi; Mode ?; Semi-Automatique; Fichier; Midi ?; Automatique; Connexion; LED 1IHM; LED 0 IHM

Initialisation UART -> MIDI
Initialisation I2S -> Audio
Initialisation I2C -> IHM
Initialisation du Wifi
Setup des routes internets
Création de la tache Sécurité
Création de la tache Audio

Ajout et Création de
l'échantillon Audio

Suppresion de l'échantillon

Envoi du buffer sur le DAC I2S

Led Vert On

Algorigramme du code ESP32
