quentinper/Orphea/020925_AA-Orphea_equipe/080925_AA_Programmation/080925_--_Document_Conception/080525_150_--_Diagramme_de_classe_ESP32.pdf

## Diagramme de classe ESP32

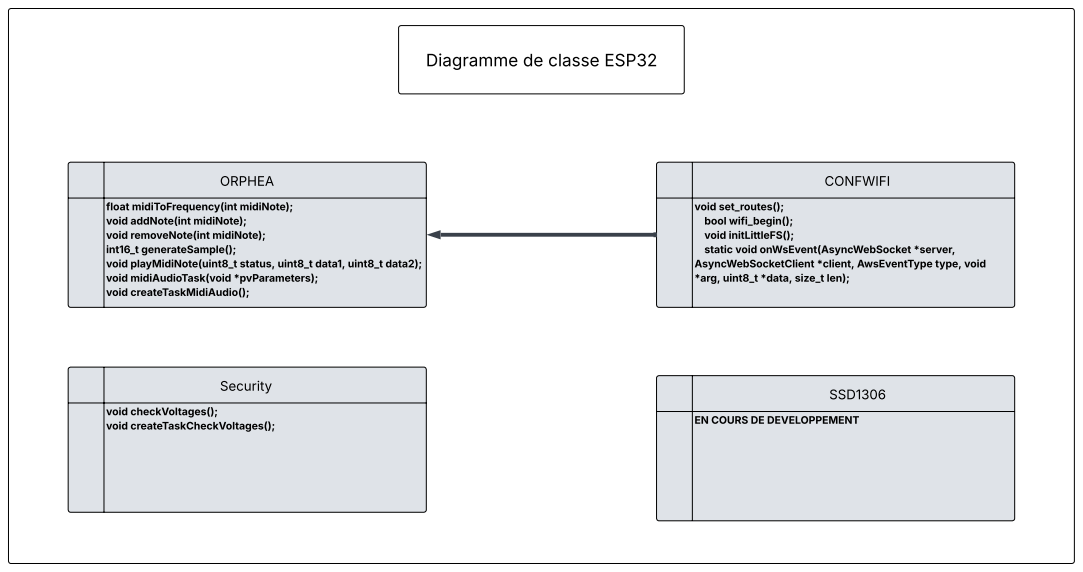
[picture p48: page 1]
ORPHEA; CONFWIFI; void checkVoltages(); void createTaskCheckVoltages();; Security; SSD1306

float midiToFrequency(int midiNote);
void addNote(int midiNote);
void removeNote(int midiNote);
int16_t generateSample();
void playMidiNote(uint8_t status, uint8_t data1, uint8_t data2);
void midiAudioTask(void * pvParameters);
void createTaskMidiAudio();

void set_routes();
bool wifi_begin();
void initLittleFS();
static void onWsEvent(AsyncWebSocket * server,
AsyncWebSocketClient * client, AwsEventType type, void
* arg, uint8_t * data, size_t len);

EN COURS DE DEVELOPPEMENT
