quentinper/Orphea/020925_AA-Orphea_equipe/030925_AA_Orphéa/030925_--_Document_Conception/030925_30_--_SCH_Orphéa.pdf

# U10 Input

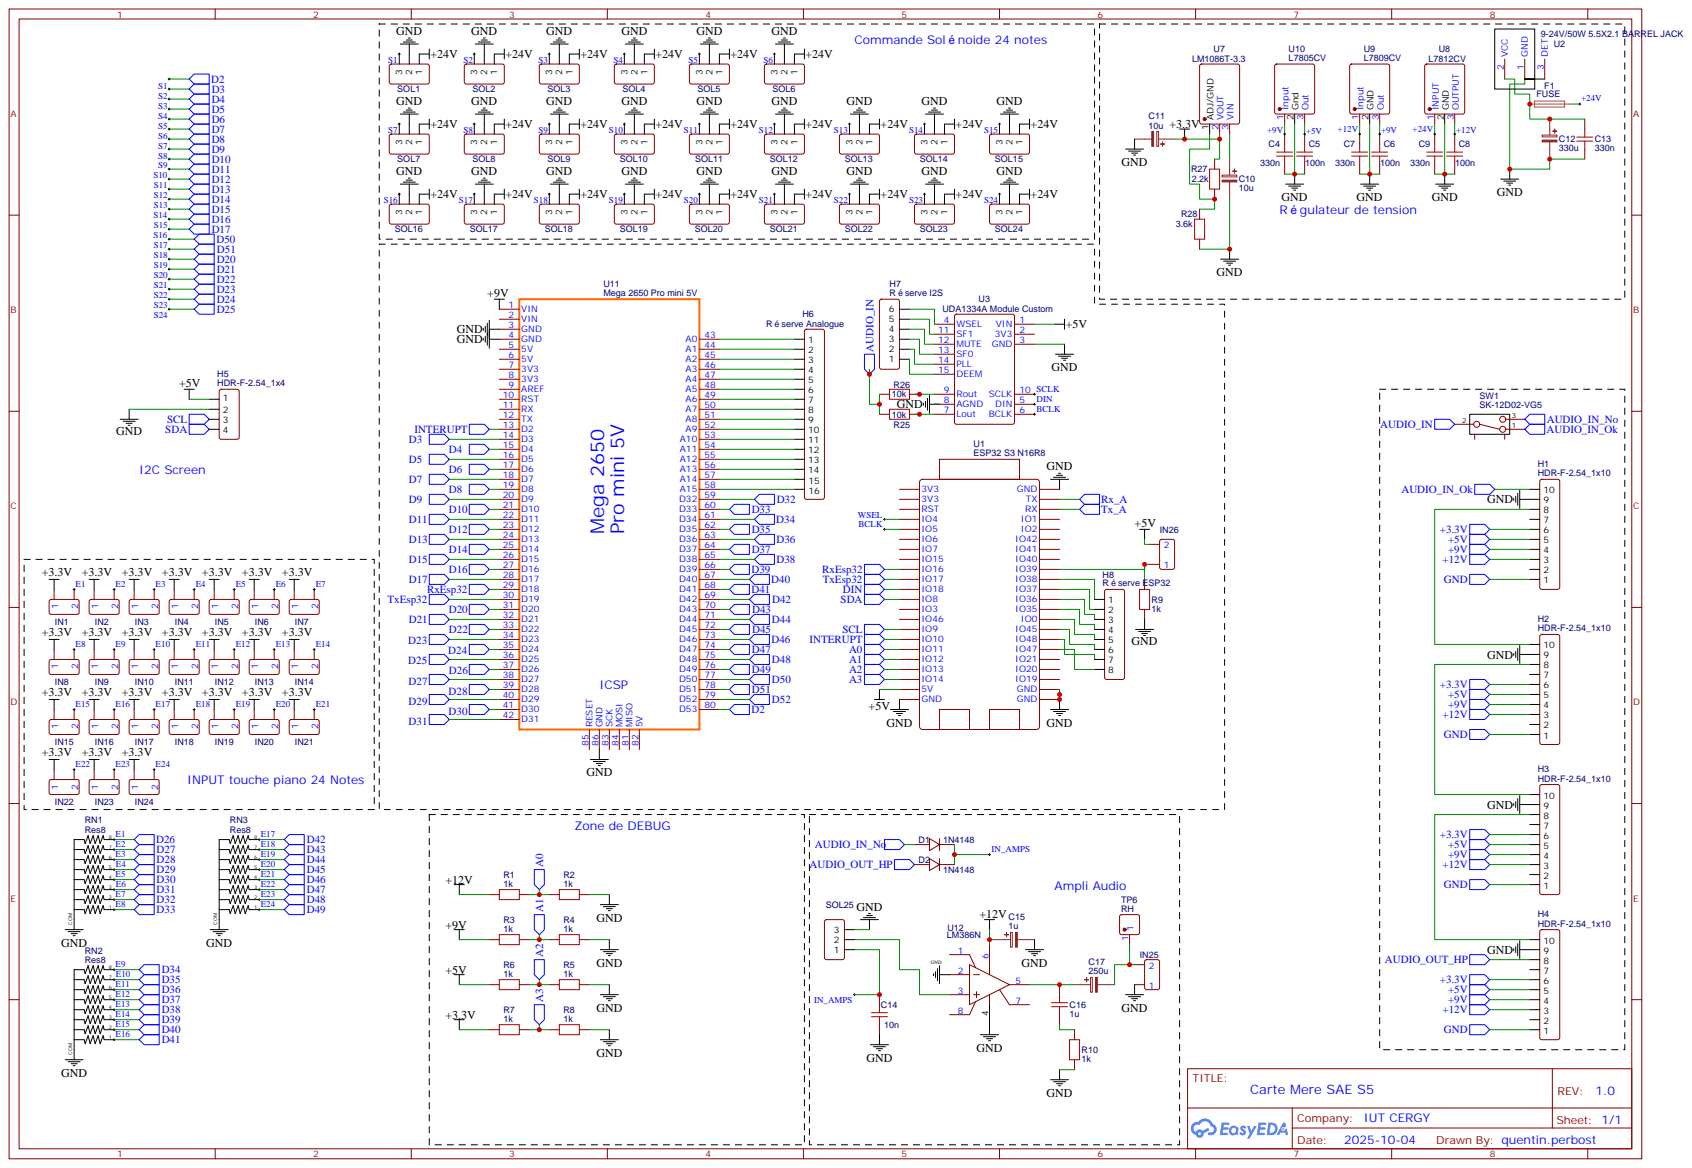
[picture p49: page 1]

Commande Sol noide 24 notes

INPUT touche piano 24 Notes

Drawn By: quentin.perbost
