quentinper/Orphea/020925_AA-Orphea_equipe/030925_AA_Orphéa/030925_--_Document_Conception/030925_30_--_SCH_Orphéa_Commande_Solénoide.pdf

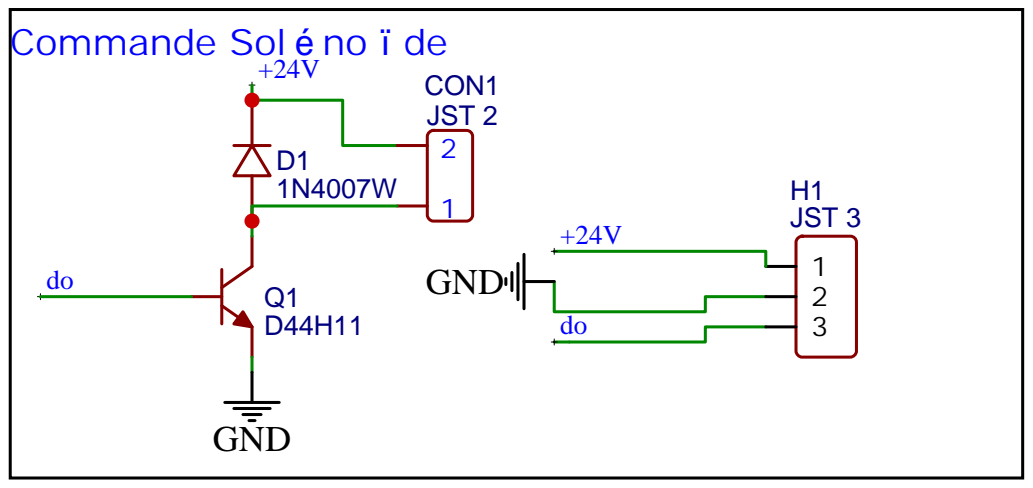
[picture p50: page 1]

Commande Sol no de

Company: IUT GEII CYU

Drawn By: quentin.perbost
