quentinper/Orphea/020925_AA-Orphea_equipe/040925_AA_Tremolo/040925_--_Document_Conception/040925_30_--_SCH_Tremolo.pdf

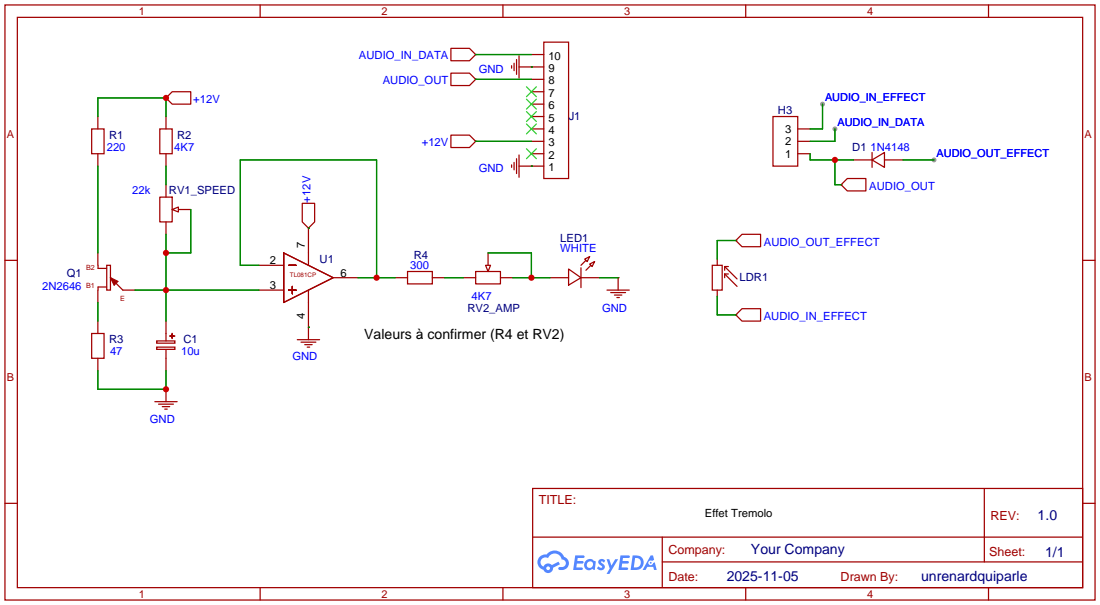
[picture p51: page 1]
