quentinper/Orphea/020925_AA-Orphea_equipe/040925_AA_Tremolo/040925_--_Document_Conception/040925_40_--_PCB_Tremolo.pdf

C1

# Tremolo V1.0

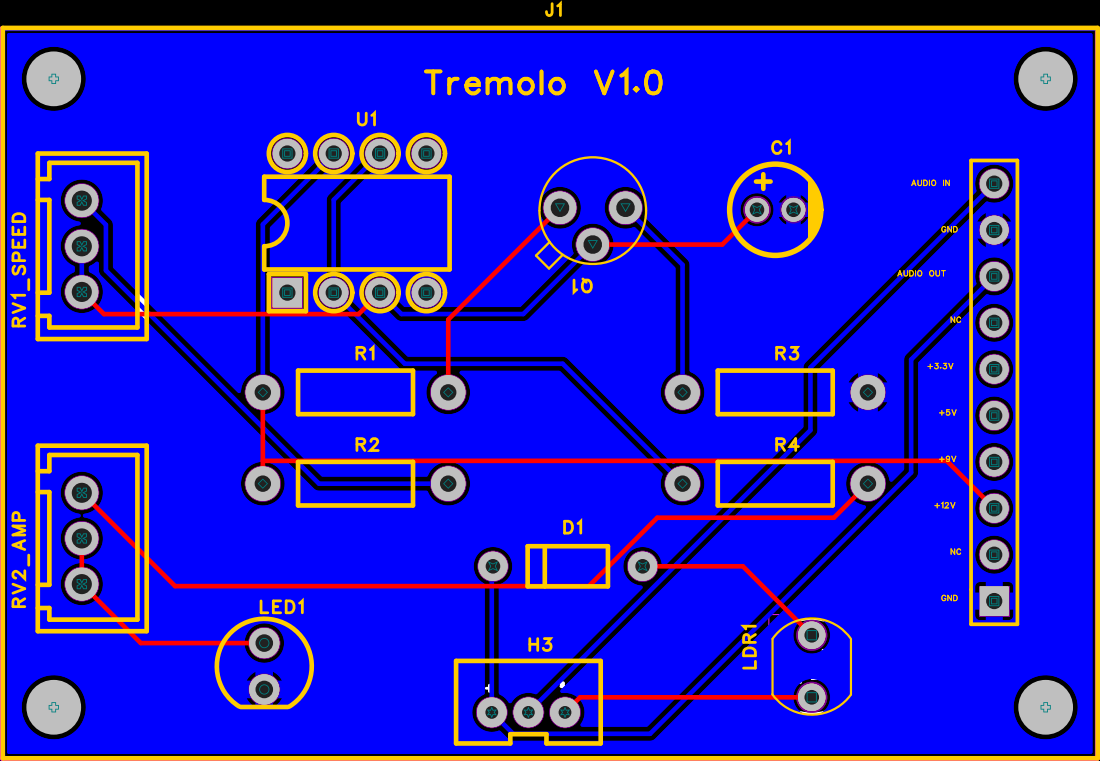
[picture p52: page 1]

C1

# Tremolo V1.0

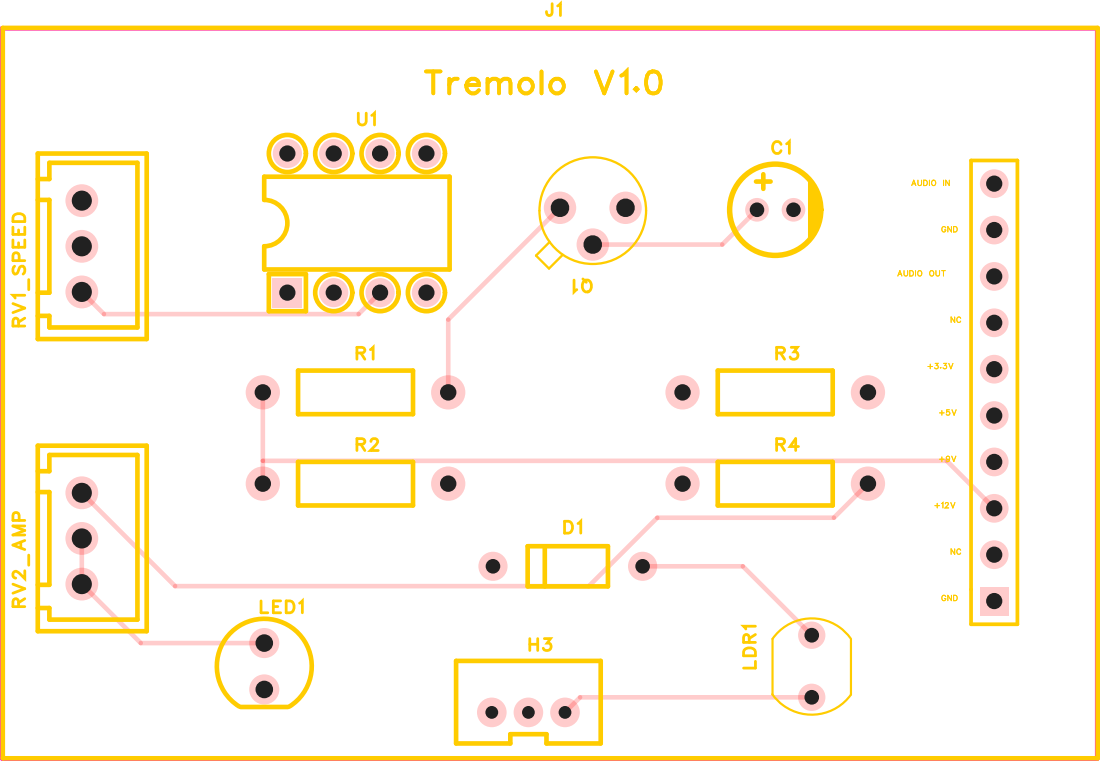
[picture p53: page 2]

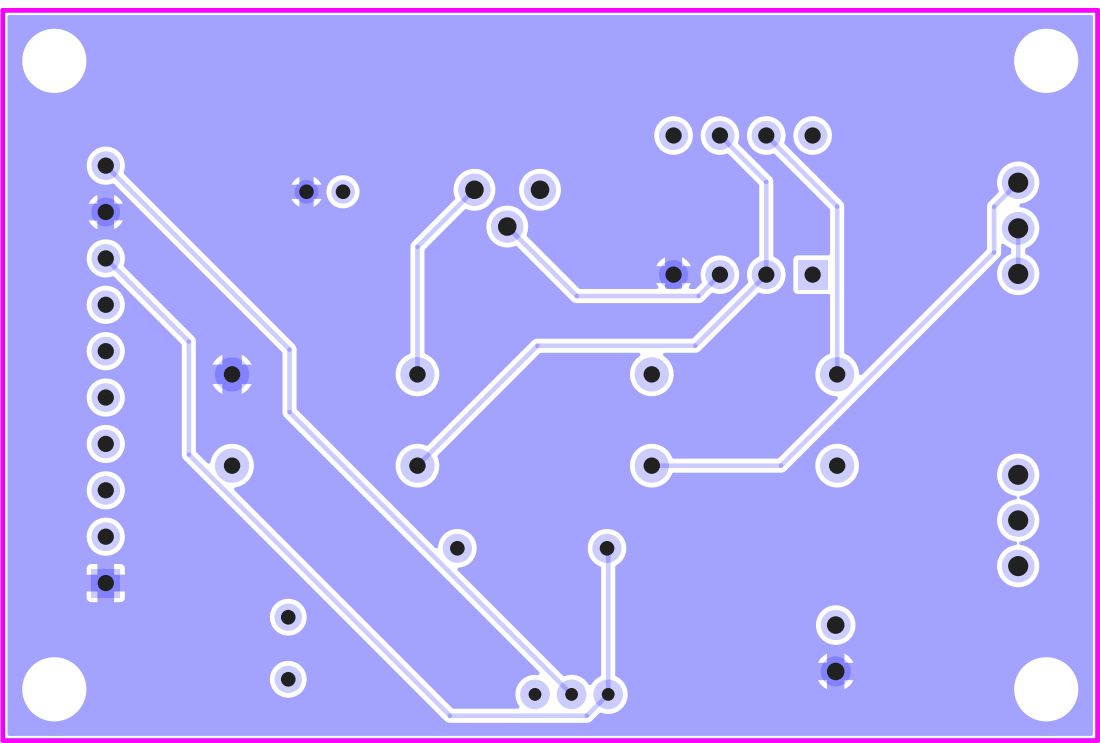
[picture p54: page 3]

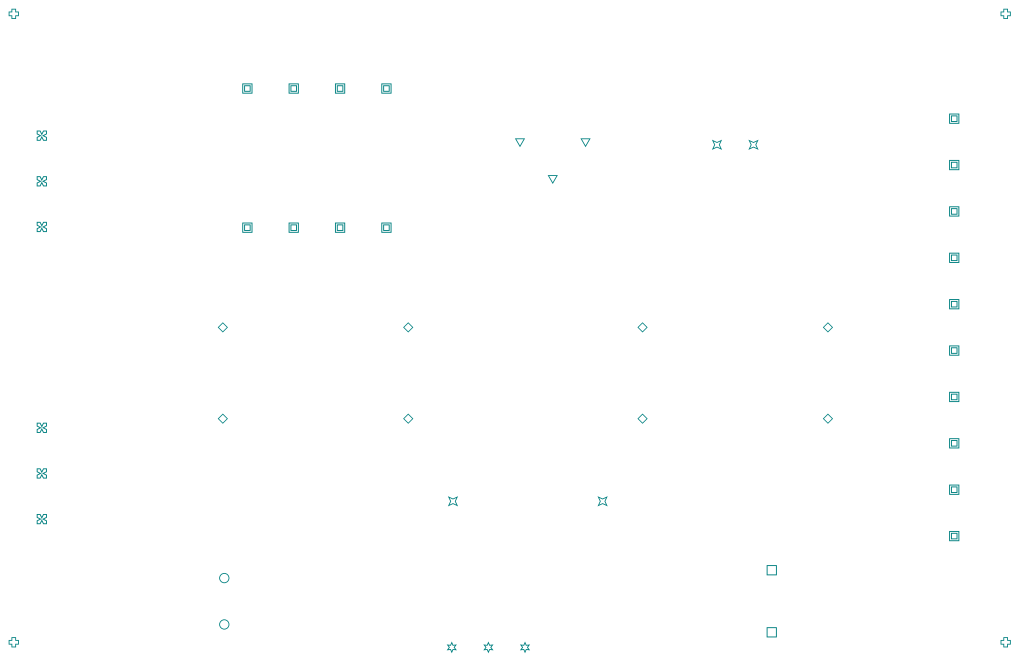
[picture p55: page 4]
