quentinper/Orphea/020925_AA-Orphea_equipe/060925_AA_Phaser/060925_--_Document_Conception/060925_30_--_SCH_Phaser.pdf

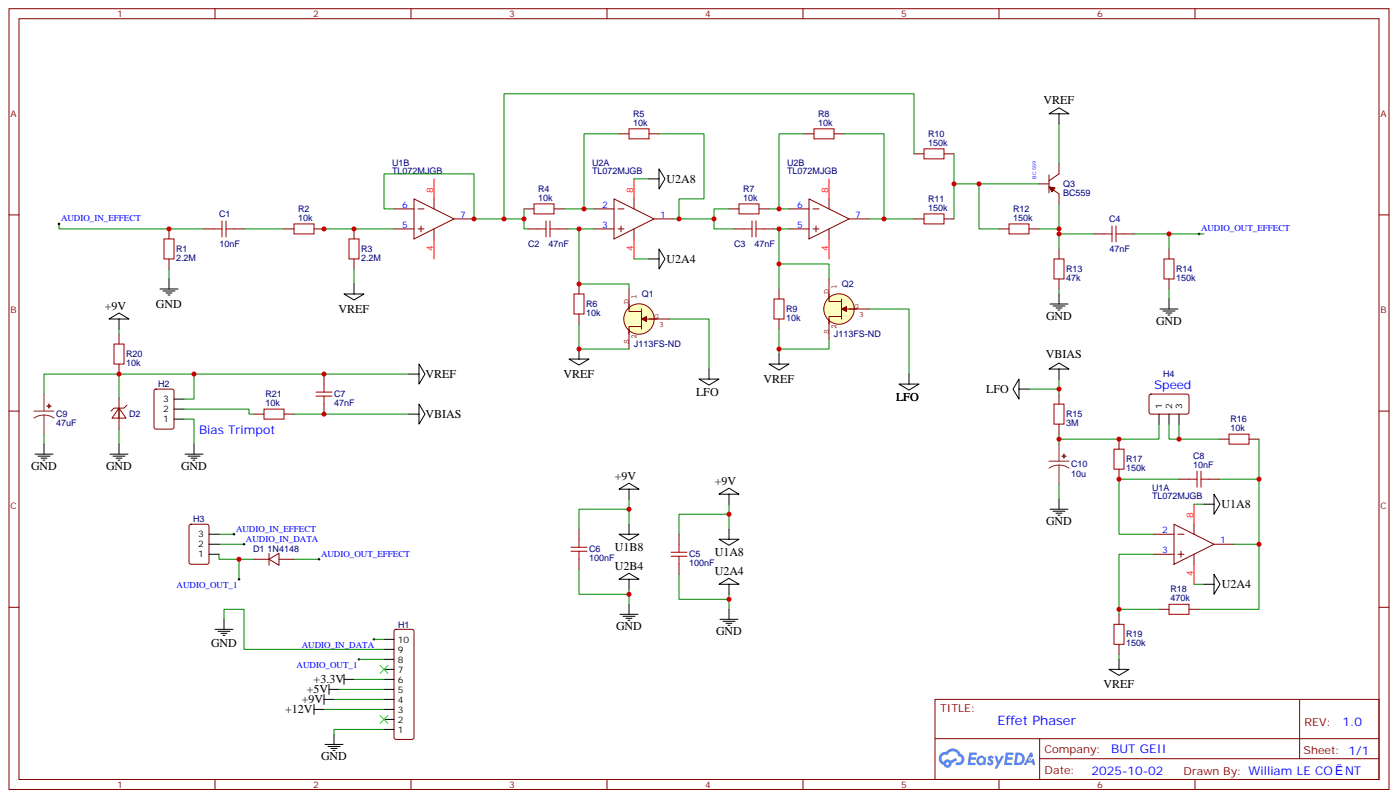
[picture p56: page 1]

Drawn By: William LE CO NT
