quentinper/Orphea/020925_AA-Orphea_equipe/060925_AA_Phaser/060925_--_Document_Conception/060925_40_--_PCB_Phaser.pdf

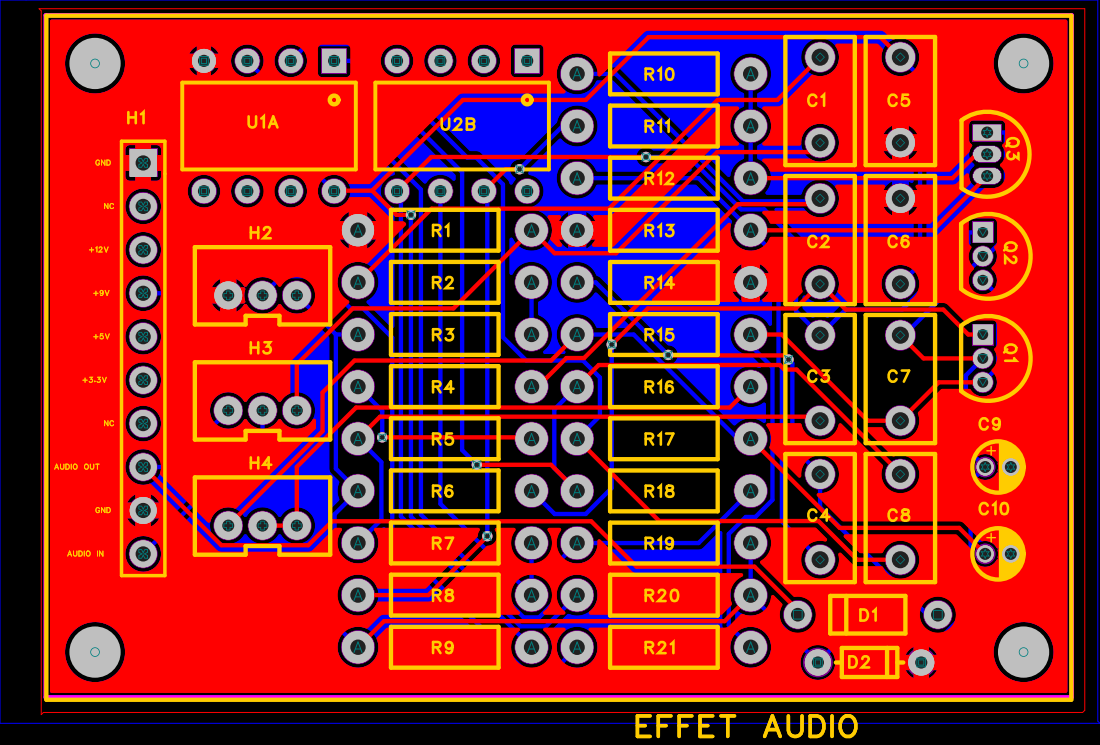
[picture p57: page 1]

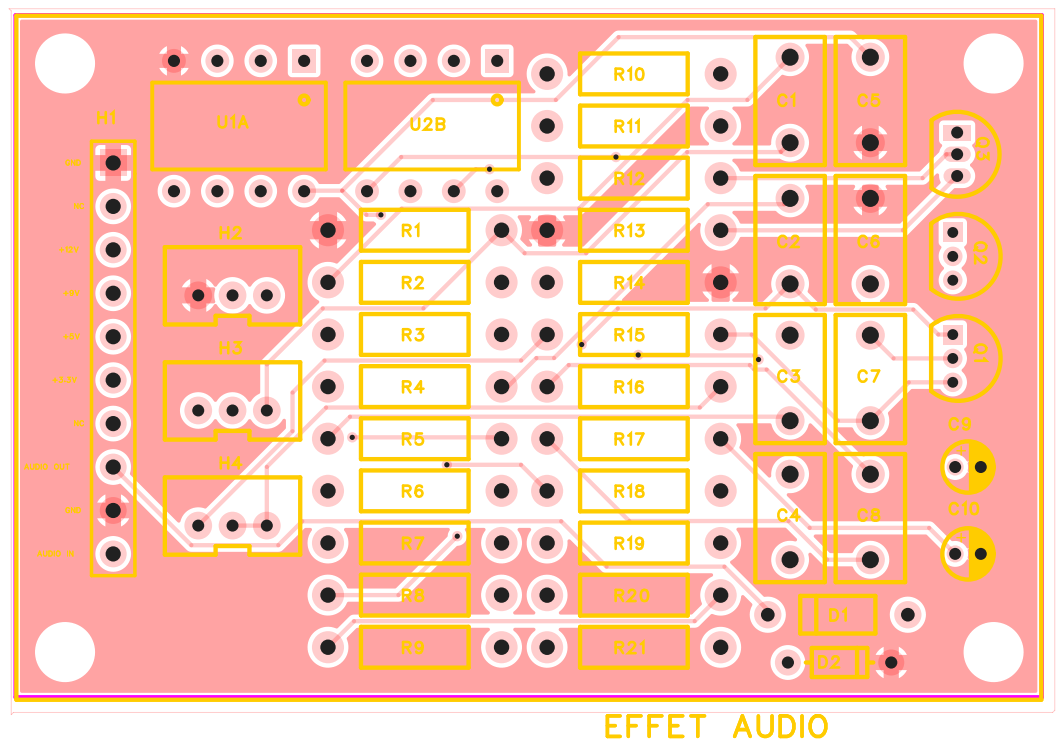
[picture p58: page 2]

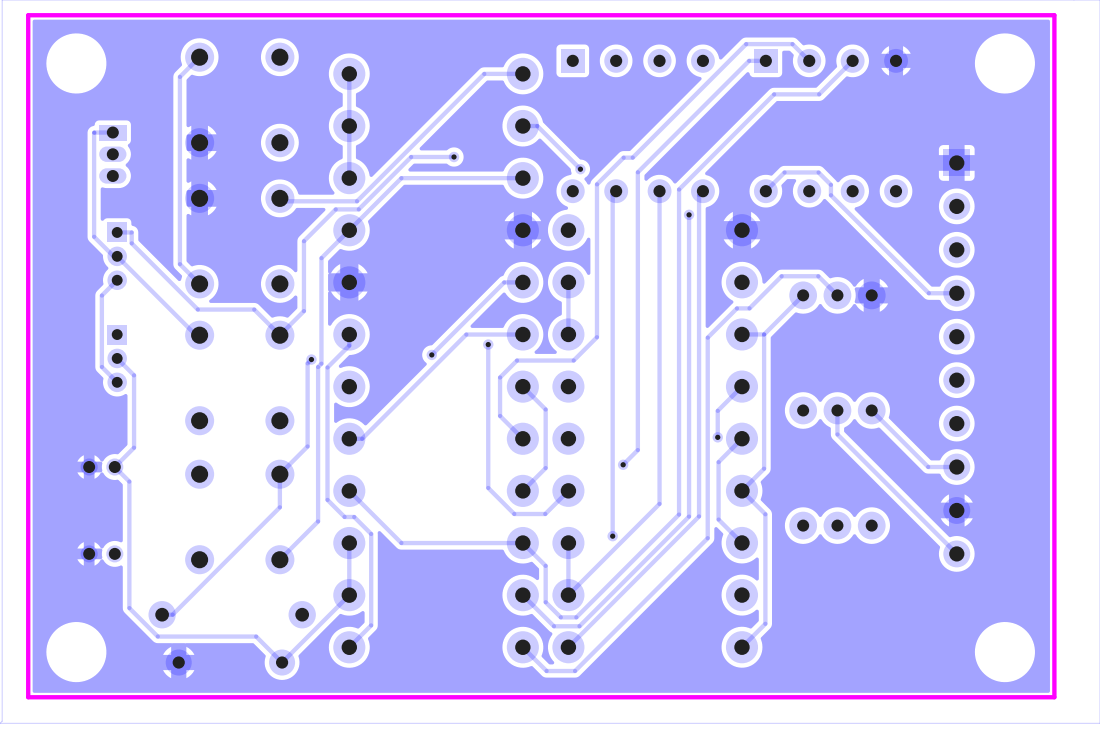
[picture p59: page 3]

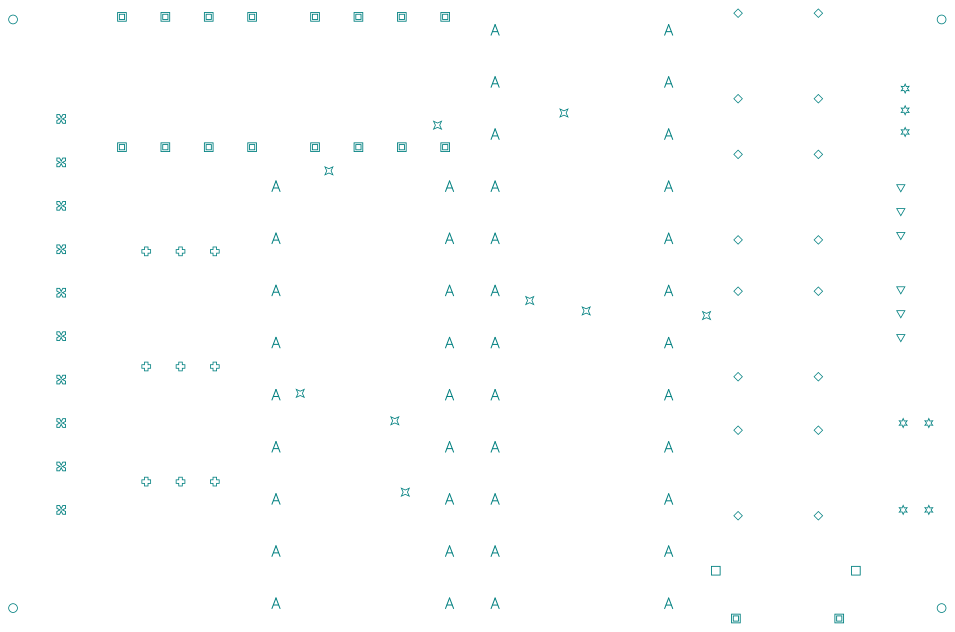
[picture p60: page 4]
