quentinper/Orphea/020925_AA-Orphéa_équipé_avancement_06.02.2026.pdf

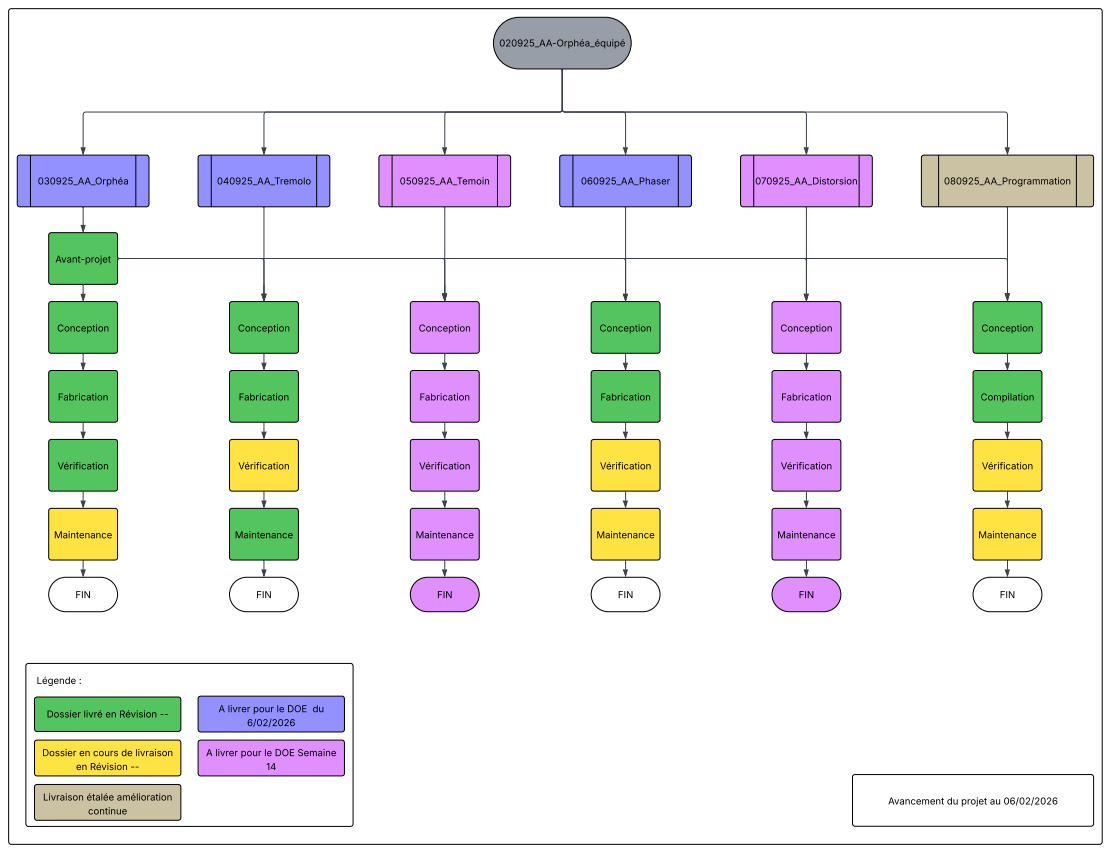
[picture p61: page 1]
030925_AA_Orphéa; 020925_AA-Orphéa_équipé; 040925_AA_Tremolo; 050925_AA_Temoin; 060925_AA_Phaser; 070925_AA_Distorsion; 080925_AA_Programmation; Avant-projet; Conception; Vérification; Fabrication; Maintenance; FIN; Compilation; en Révision --; continue; Légende :

A livrer pour le DOE du

Dossier livré en Révision --

Dossier en cours de livraison

A livrer pour le DOE Semaine

Livraison étalée amélioration

Avancement du projet au 06/02/2026
