quentinper/Orphea/020925_AA-Orphea_equipe/030925_AA_Orphéa/030925_--_Document_Avant_Projet/030925_05_--_Gantt.pdf

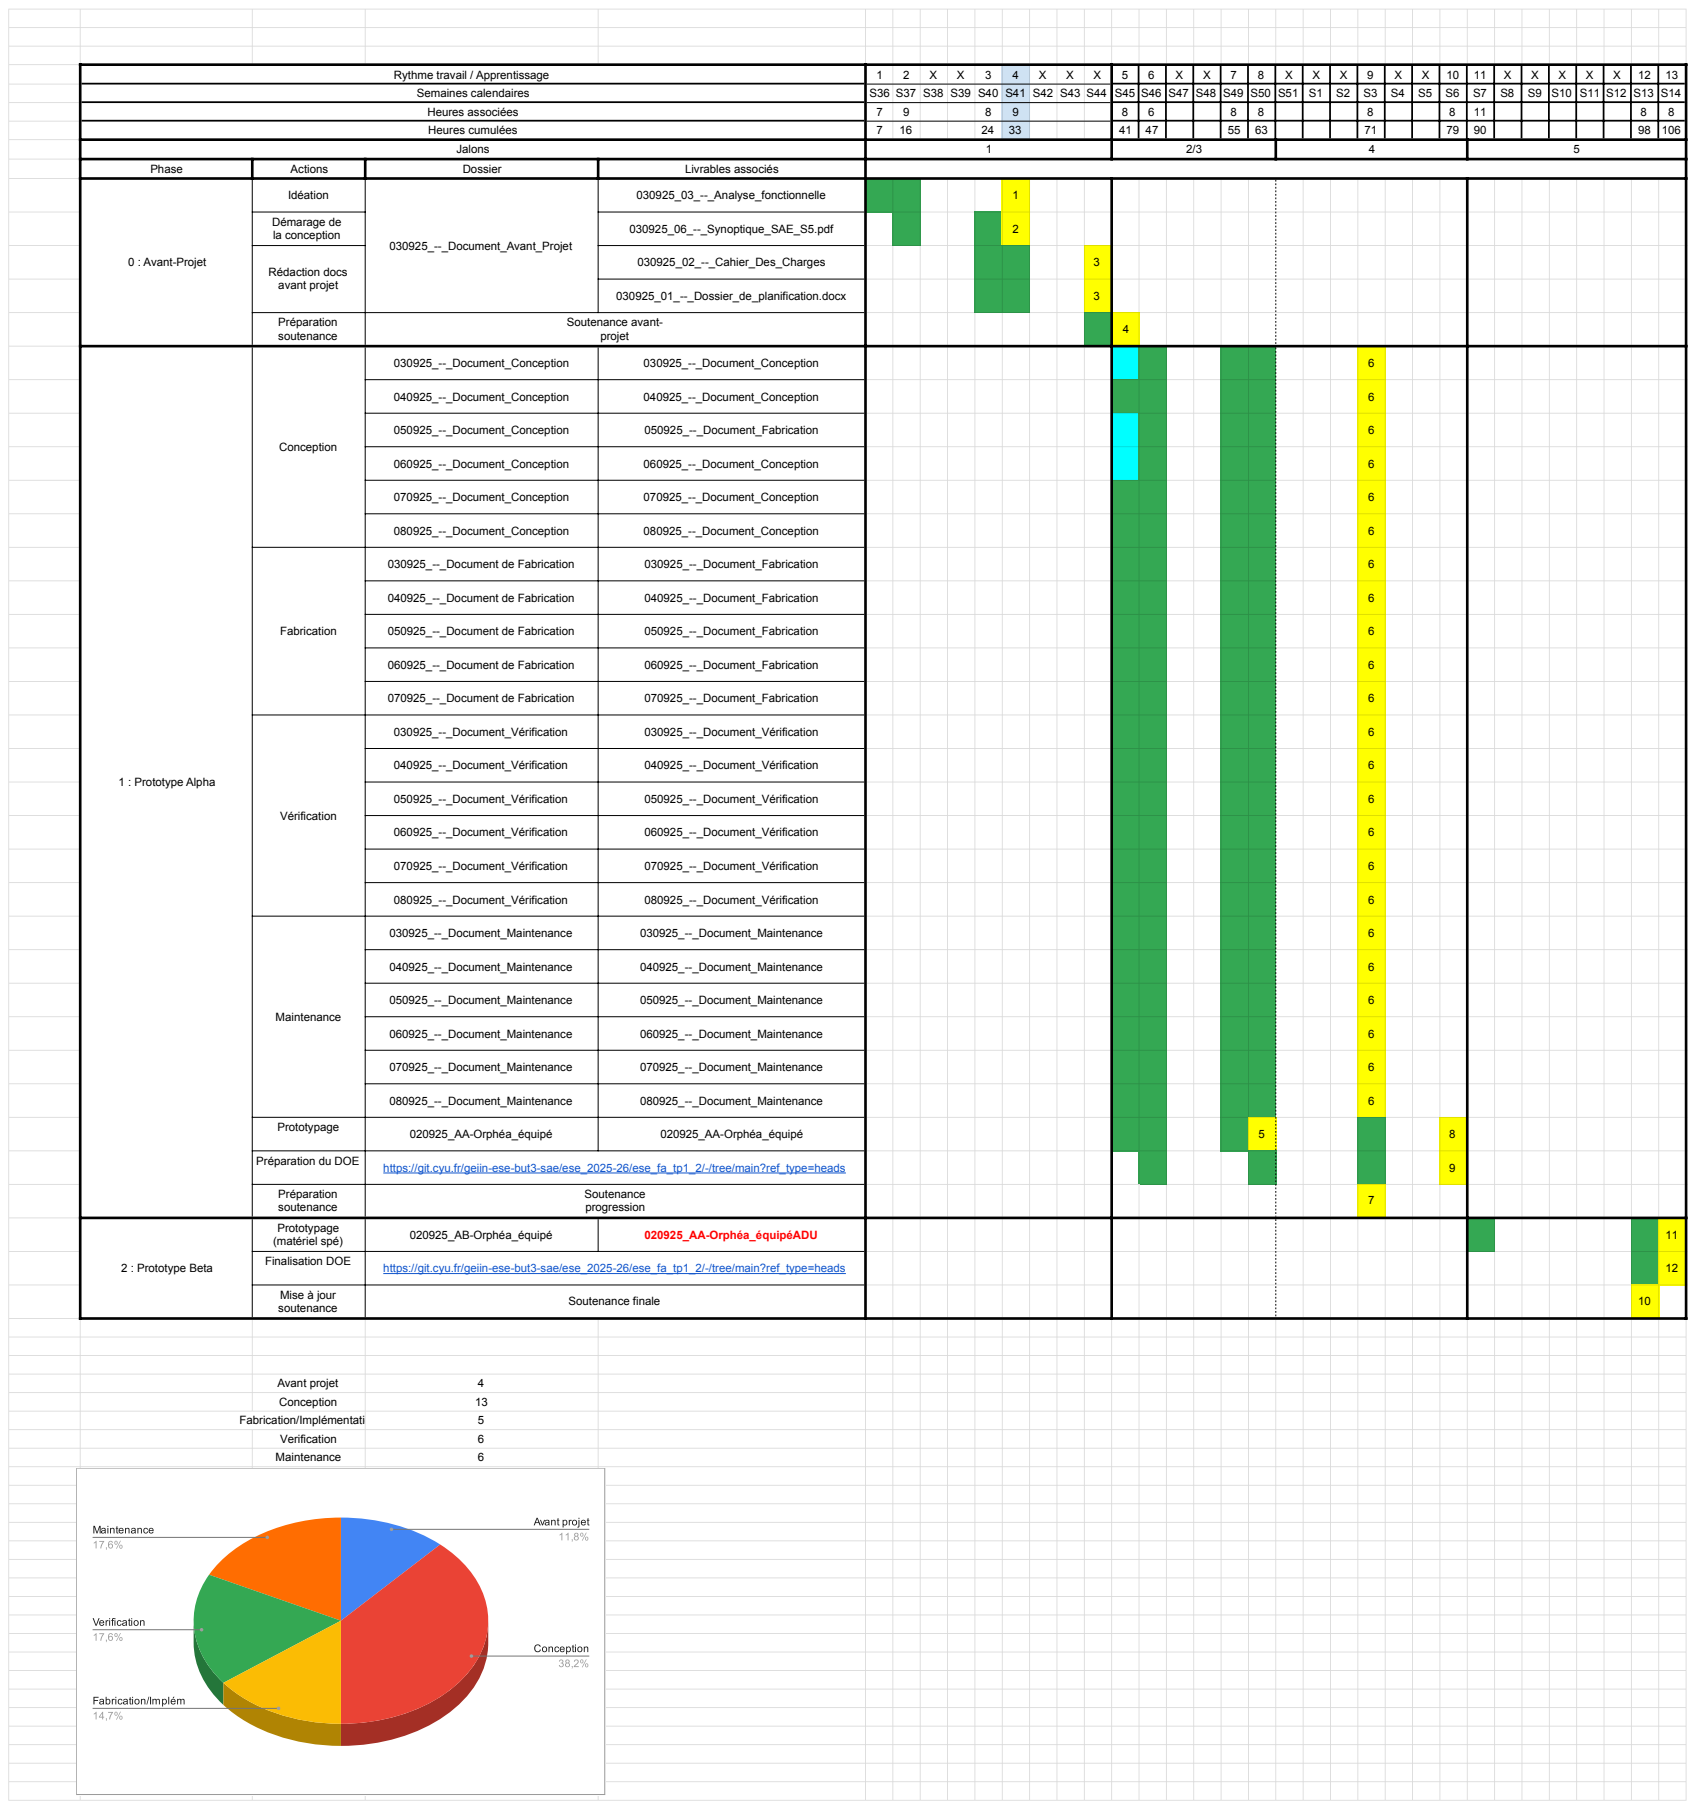
[picture p62: page 1]
0 : Avant-Projet; Idéation; 030925_--_Document_Avant_Projet; 030925_03_--_Analyse_fonctionnelle; Démarage de; la conception; 030925_06_--_Synoptique_SAE_S5.pdf; Rédaction docs avant projet; 030925_02_--_Cahier_Des_Charges; 030925_01_--_Dossier_de_planification.docx; Préparation soutenance; Soutenance avant-; projet; 1 : Prototype Alpha; 030925_--_Document_Conception; 040925_--_Document_Conception; 050925_--_Document_Conception; 050925_--_Document_Fabrication; 060925_--_Document_Conception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

Rythme travail / Apprentissage | 1 2 X X 3 4 X X X | 5 | 6 | X | X | 7 | 8 | X | X | X | 9 | X | X | 10 | 11 | X | X | X | X | X | 12 | 13
Semaines calendaires | S36 S37 S38 S39 S40 S41 S42 S43 S44 | S45 | S46 | S47 | S48 | S49 | S50 | S51 | S1 | S2 | S3 | S4 | S5 | S6 | S7 | S8 | S9 | S10 | S11 | S12 | S13 | S14
Heures associées | 7 9 8 9 | 8 | 6 | | | 8 | 8 | | | | 8 | | | 8 | 11 | | | | | | 8 | 8
Heures cumulées | 7 16 24 33 | 41 | 47 | | | 55 | 63 | | | | 71 | | | 79 | 90 | | | | | | 98 | 106
Jalons | 1 | 2/3 | | | | | | 4 | | | | | | | 5

Phase | Actions | Dossier | Livrables associés

Conception

Fabrication

Vérification

Maintenance

Préparation soutenance | Soutenance progression

2 : Prototype Beta | Prototypage (matériel spé) | 020925_AB-Orphéa_équipé | 020925_AA-Orphéa_équipéADU | 11 12 10

Finalisation DOE | https://git.cyu.fr/geiin-ese-but3-sae/ese_2025-26/ese_fa_tp1_2/-/tree/main?ref_type=heads

Mise à jour soutenance | Soutenance finale
