quentinper/Orphea/020925_AA-Orphea_equipe/030925_AA_Orphéa/030925_--_Document_Avant_Projet/030925_06_--_Synoptique_SAE_S5.pdf

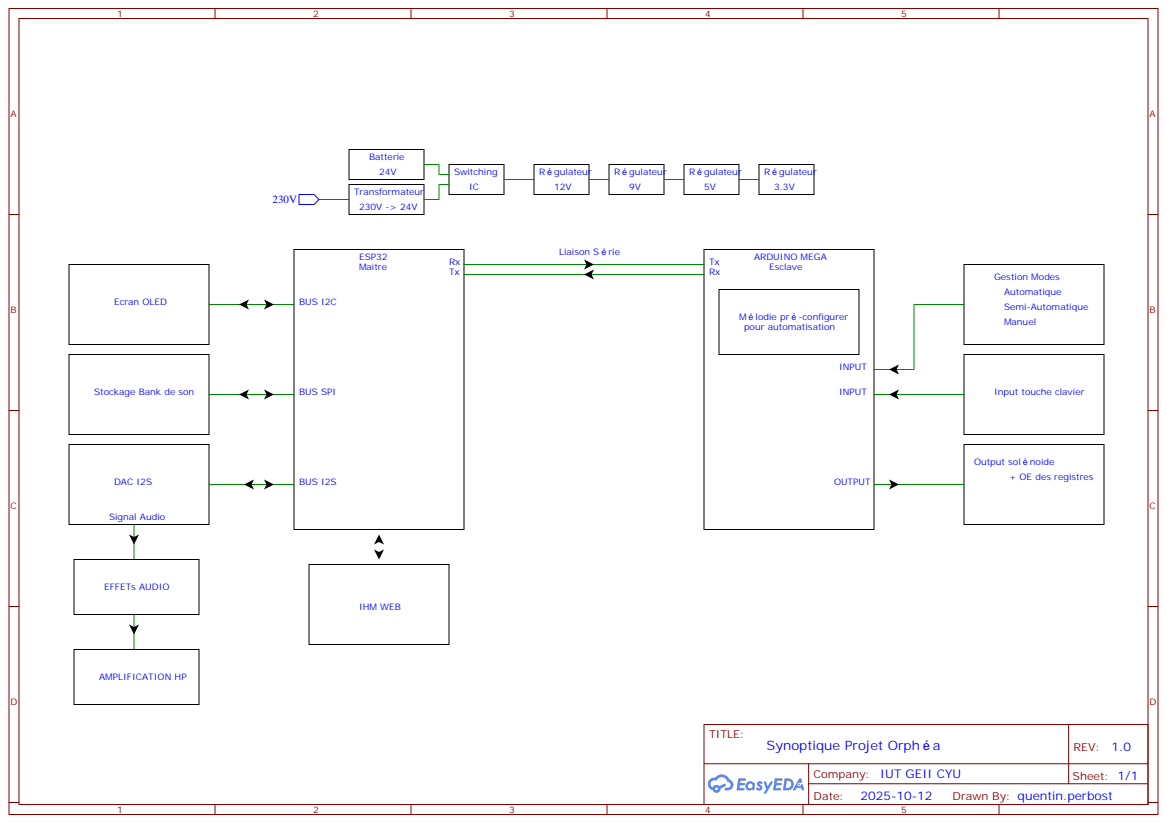
[picture p63: page 1]

Company: IUT GEII CYU

Drawn By: quentin.perbost
