quentinper/Orphea/020925_AA-Orphea_equipe/080925_AA_Programmation/080925_--_Document_Conception/080925_--_Melodie/src/main.cpp

#include <Arduino.h>
#include <SOLENOIDE.h>
// #include "CONFNOT.h"
#include <GESTNOTES.h>

SOLENOIDE mySolenoide;
GESTNOTES myGestNotes;

// Code Arduino pour détecter les fronts montants et descendants sur 24 boutons
// Utilise le polling (scrutation logicielle) car les interruptions matérielles sont limitées (seulement 2 sur Uno)
// Adapté pour un Arduino Mega (qui a plus de broches) ou utilisez des registres à décalage pour étendre les entrées

#define NUM_BUTTONS 24
#define NOTE_1  26
#define NOTE_2  27
#define NOTE_3  28
#define NOTE_4  29
#define NOTE_5  30
#define NOTE_6  31
#define NOTE_7  32
#define NOTE_8  33
#define NOTE_9  34
#define NOTE_10 35
#define NOTE_11 36
#define NOTE_12 37
#define NOTE_13 38
#define NOTE_14 39
#define NOTE_15 40
#define NOTE_16 41
#define NOTE_17 42
#define NOTE_18 43
#define NOTE_19 44
#define NOTE_20 45
#define NOTE_21 46
#define NOTE_22 47
#define NOTE_23 48
#define NOTE_24 49

#define SOL_1  53
#define SOL_2  3
#define SOL_3  4
#define SOL_4  5
#define SOL_5  6
#define SOL_6  7
#define SOL_7  8
#define SOL_8  9
#define SOL_9  10
#define SOL_10  11
#define SOL_11 12
#define SOL_12 13
#define SOL_13  14
#define SOL_14  15
#define SOL_15  16
#define SOL_16  17
#define SOL_17  50
#define SOL_18  51
#define SOL_19  20
#define SOL_20  21
#define SOL_21 22
#define SOL_22  23
#define SOL_23  24
#define SOL_24  25




const int buttonPins[NUM_BUTTONS] = 
{
  NOTE_1, NOTE_2, NOTE_3, NOTE_4, NOTE_5, NOTE_6, NOTE_7, NOTE_8, NOTE_9, NOTE_10, 
  NOTE_11, NOTE_12, NOTE_13, NOTE_14, NOTE_15, NOTE_16, NOTE_17, NOTE_18, NOTE_19, 
  NOTE_20, NOTE_21, NOTE_22, NOTE_23, NOTE_24
}; // Exemple de broches (ajustez selon votre carte)

const int solenoidPins[NUM_BUTTONS] = 
{ 
  SOL_1, SOL_2, SOL_3, SOL_4, SOL_5, SOL_6, 
  SOL_7, SOL_8, SOL_9, SOL_10, SOL_11, SOL_12, SOL_13, SOL_14, SOL_15, SOL_16, SOL_17,
  SOL_18, SOL_19, SOL_20, SOL_21, SOL_22, SOL_23, SOL_24 
}; // Broches des solénoïdes correspondantes (ajustez selon votre carte)

volatile bool risingEdgeDetected[NUM_BUTTONS] = {false};
volatile bool fallingEdgeDetected[NUM_BUTTONS] = {false};
bool lastButtonStates[NUM_BUTTONS] = {HIGH}; // État précédent de chaque bouton (HIGH par défaut avec pull-up)
bool DEBUG = false;
int getNote(int i);

int detectSol(int note)
{
  if(note == 60)return SOL_1;
  if(note == 61)return SOL_2;
  if(note == 62)return SOL_3;
  if(note == 63)return SOL_4;
  if(note == 64)return SOL_5;
  if(note == 65)return SOL_6;
  if(note == 66)return SOL_7;
  if(note == 67)return SOL_8;
  if(note == 68)return SOL_9;
  if(note == 69)return SOL_10;
  if(note == 70)return SOL_11;
  if(note == 71)return SOL_12;
  if(note == 72)return SOL_13; 
  if(note == 73)return SOL_14; 
  if(note == 74)return SOL_15; 
  if(note == 75)return SOL_16; 
  if(note == 76)return SOL_17; 
  if(note == 77)return SOL_18; 
  if(note == 78)return SOL_19; 
  if(note == 79)return SOL_20; 
  if(note == 80)return SOL_21; 
  if(note == 81)return SOL_22; 
  if(note == 82)return SOL_23; 
  if(note == 83)return SOL_24;
}

void setup()
{
  Serial.begin(115200);
  Serial1.begin(31250);
  Serial.println("Initialisation...");
  for (int i = 0; i < NUM_BUTTONS; i++)
  {
    pinMode(buttonPins[i], INPUT_PULLUP); // Configuration en entrée avec pull-up interne
    pinMode(solenoidPins[i], OUTPUT); // Configuration des broches des solénoïdes en sortie digitalWrite(solenoidPins[i], LOW); // Assurez-vous que les solénoïdes sont éteints au démarrage
  }
  
}

void loop()
{
  // Scrutation logicielle pour détecter les fronts
  /*
  for (int i = 0; i < NUM_BUTTONS; i++)
  {
    bool currentState = digitalRead(buttonPins[i]);
    if(DEBUG)
    {
      for(int i = 0 ; i < NUM_BUTTONS; i++)
      {
        risingEdgeDetected[i] = true;
        if (risingEdgeDetected[i])
        {
          int strg = getNote(i);
          Serial1.write(0x90);
          Serial1.write(strg);
          Serial1.write(100);
          Serial.write(0x90);
          Serial.write(strg);
          Serial.write(100);
        }
        delay(1000);
        fallingEdgeDetected[i] = true;
        if (fallingEdgeDetected[i])
        {
          int strg = getNote(i);
          Serial1.write(0x80);
          Serial1.write(strg);
          Serial1.write((byte)0);
          Serial.write(0x80);
          Serial.write(strg);
          Serial.write((byte)0);
          fallingEdgeDetected[i] = false;
        }
      }
    }
    if (lastButtonStates[i] == LOW && currentState == HIGH)
    {
      risingEdgeDetected[i] = true;
    }
    else if (lastButtonStates[i] == HIGH && currentState == LOW)
    {
      fallingEdgeDetected[i] = true;
    }

    lastButtonStates[i] = currentState;
  }

  // Traitement des détections dans la boucle principale
  for (int i = 0; i < NUM_BUTTONS; i++)
  {
    if (risingEdgeDetected[i])
    {
      int strg = getNote(i);
      Serial1.write(0x90);
      Serial1.write(strg);
      Serial1.write(100);
      Serial.write(0x90);
      Serial.write(strg);
      Serial.write(100);
      risingEdgeDetected[i] = false;
    }

    if (fallingEdgeDetected[i])
    {

      int strg = getNote(i);
      Serial1.write(0x80);
      Serial1.write(strg);
      Serial1.write((byte)0);
      Serial.write(0x80);
      Serial.write(strg);
      Serial.write((byte)0);
      fallingEdgeDetected[i] = false;
    }
  }

  delay(10);
  */ // Petit délai pour éviter le rebond (debouncing simple), ajustez si nécessaire
  if (Serial1.available() >= 3) 
    {
     // Serial.print("test");
      uint8_t status = Serial1.read();// 0x90 ou 0x80
      uint8_t data1 = Serial1.read();//  note(0-127)
      uint8_t data2 = Serial1.read();//  velocity(0-127) -> 0 = note off
      if (status >= 0x80) {
        if(status==0x90){
         digitalWrite(detectSol(data1),HIGH);
        }
        else if(status==0x80){
          digitalWrite(detectSol(data1),LOW);
      }
    }

    }
  }

int getNote(int i)
{
  {
    // Décalage MIDI constant (Offset).
    // Si l'index 0 correspond à la note 61, l'offset est 61.
    const int MIDI_OFFSET = 84;

    // Vérifie si l'index est dans la plage de 0 à 23.
    if (i >= 0 && i <= 23)
    {
      // Calcul direct : Note MIDI = Index + Décalage
      // Exemple : i=0 => 0 + 61 = 61
      // Exemple : i=23 => 23 + 61 = 84
      return MIDI_OFFSET - i;
    }

    // Retourne 0 si l'index est invalide (bonne pratique pour les erreurs/valeur par défaut)
    return 0;
  }
  // ---- Fonctions d'envoi MIDI ----
}
