quentinper/Orphea/020925_AA-Orphea_equipe/080925_AA_Programmation/080925_--_Document_Conception/080925_--_Orphea/src/main.cpp

/***************************************************************
 * @file        main.cpp
 * @author      Lorenzo S. & Quentin P. & William L-C
 * @version     1
 * @date        2026-01-24
 * @brief       Gestion du système audio ORPHEA.
 * @details     SAE S5-S6 BUG GEII FA ESE
 * @copyright   (c)  Lorenzo S. & Quentin P. & William L-C - Tous droits réservés
 ***************************************************************/

/**********
   Includes : 
 ***********/
#include <Arduino.h>
#include <CONFWIFI.h>
#include <SECURITY.h>
#include <ORPHEA.h>
#include <SSD1306.h>

/**********
   Address : 
 ***********/
#define SSD1306_ADR 0x3C

/**********
   Flags : 
 ***********/
bool DEBUG = 0; // Activer les messages de debug
bool SETUP = 1; // Activer les messages de trace
bool ERROR = 0; // Activer les messages d'erreur
bool LATENCY_CHECK = 0;


/**********
   Object : 
 ***********/
CONFWIFI myWiFi;
SECURITY mySecurity;
ORPHEA myOrphea;
SSD1306 mySSD1306;


/*************************************************************************************************
 * @brief Fonction d'initialisation du système. Elle configure la fréquence CPU, initialise 
 *        les tâches de synthèse audio MIDI, la vérification des tensions et le module WiFi,
 *        ainsi que l'écran OLED.
 **************************************************************************************************/
void setup() 
{
  setCpuFrequencyMhz(240);                                   // Maximiser la fréquence CPU pour la génération audio
  Serial.begin(115200);                                      // Initialiser la communication série pour le debug
  myOrphea.createTaskMidiAudio();                            // Initialiser la tâche audio MIDI
  mySecurity.createTaskCheckVoltages();                      // Initialiser la tâche de vérification des tensions
  myWiFi.wifi_begin();                                       // Initialiser le module WiFi
  mySSD1306.beginOLED(SSD1306_ADR);                          // Initialiser l'écran OLED
}


/*************************************************************************************************
 * @brief Fonction de boucle principale. Elle est volontairement laissée vide car toutes les tâches
 *        sont gérées par FreeRTOS sur les différents cores.
 *        Un délai est ajouté pour éviter une utilisation CPU à 100% inutile.
 **************************************************************************************************/
void loop()
{
  delay(100);
}
